KeitoKuramochi/sensor_infrared/site/images/wiring-1.jpg

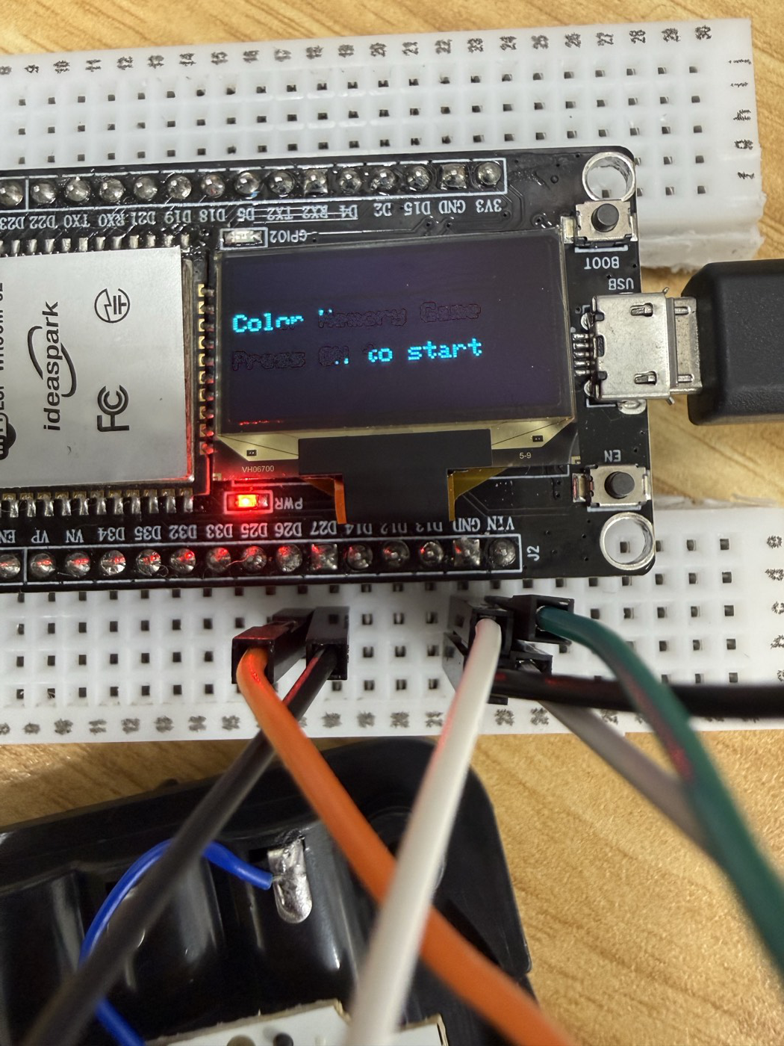
site/images/wiring-1.jpg
