KeitoKuramochi/sensor_infrared/site/images/setup-bt.jpg

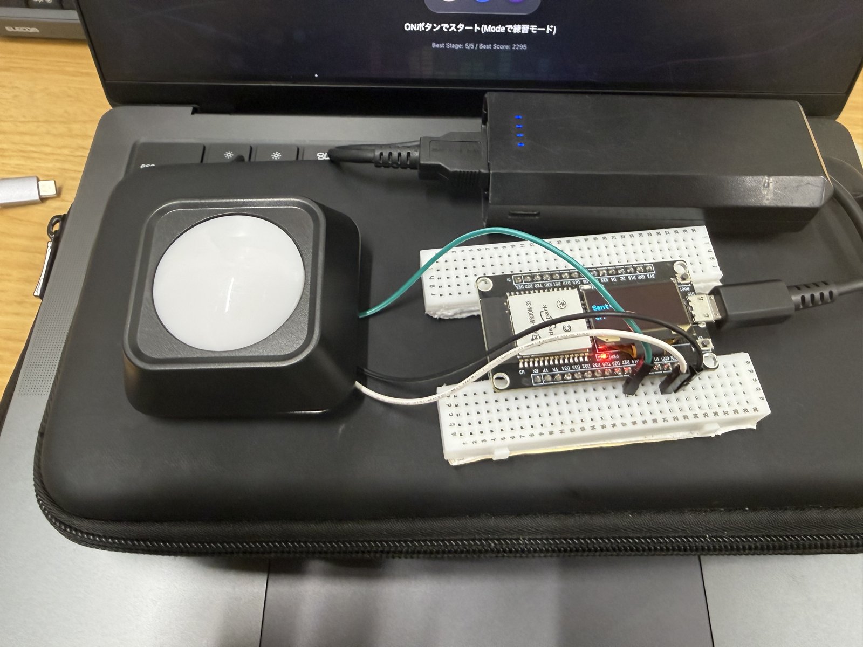
site/images/setup-bt.jpg
