KeitoKuramochi/sensor_infrared/SESSION_LOG.md

# Session Log

このファイルは、どのセッション/どのマシンからでも「今何をしているか」を共有するための進捗ログです。
新しいセッションを始めるときはまずこのファイルを読んで直近の状況を確認し、作業を終える前に新しいエントリを一番上に追記してください(過去のエントリは消さない)。

フォーマット:

```
## YYYY-MM-DD HH:MM - 短いタイトル
- やったこと
- 現在の状態
- 次にやること
```

## 2026-08-03 - 「まず読むメモ」(START_HERE.md)を作成 + ルート直下を 素材/ に整理 + フォルダ改名の調査(改名は未実施)

- ユーザー要望①「このフォルダ名を sensor から opencampus2026 系に変えたい。セッションが引き継げない等はあるか」
  → プランモードで調査したが、名前の確定前にユーザーが方針転換したため **改名は未実施**。調査結果だけ残す:
  - **会話履歴は引き継がれない。** Claude Code は cwd のパスから履歴フォルダ名を作るため
    (`/Users/.../hobby/sensor` → `~/.claude/projects/-Users-kuramochikeito-Desktop-hobby-sensor/`、
    記号は全て `-` に置換)、改名すると空の新フォルダが使われる。現在15セッション・135MB ある。
    履歴フォルダを新しい名前(例 `-Users-kuramochikeito-Desktop-hobby-opencampus2026`)に mv すれば引き継げる
  - `~/.claude.json` の `projects` も絶対パスがキー。改名すると信頼ダイアログが再度出る(実害は軽微)
  - **git は一切影響を受けない**(リモート・履歴そのまま)。`opencampus/` の別リポジトリも無事。
    venv や node_modules は無いので絶対パスの埋め込みも無し
  - **改名するなら必ず直すファイル: `.claude/settings.json`**(フォルダ外書き込み禁止フックが
    旧パスをハードコードしているため、放置すると全ての Edit/Write がブロックされる)。
    他に `CLAUDE.md` 4行目、`動作用.txt` 2行目。SESSION_LOG の過去エントリは履歴なので触らない
  - 日本語やドットを含む名前は履歴フォルダ名が潰れて他プロジェクトと衝突しうるので英数字推奨
  - フォルダ本体の mv と履歴フォルダの移行は**フォルダ外の操作なので CLAUDE.md 上 Claude は実行できない**。
    ユーザーが実行するか、明示的に許可をもらう必要がある
- ユーザー要望②「このフォルダで何をしたか、記事みたいに超見やすくまとめた『まず読むメモ』を作って」
  → **`START_HERE.md` を新規作成**。README(手順書)・SESSION_LOG(作業記録)とは別の、5分で全体を掴む用の1枚:
  - 一行要約 / 現在の構成(mermaid図 + 区間ごとの通信方式の表)/ 動かし方3ステップ / フォルダの歩き方
  - 「これまでの物語」を7章立てで記事化(100均で部品を漁る → 無線との長い戦い → 見た目 → ガチャ連携 →
    展示に耐える形へ → 本番と有線回帰 → 外向けページ)。**2回の誤診(無線ハード故障・アンテナ劣化)も明記**
  - ハマりどころ早見表(bleak<3、広告パケット31B、response=True、UUID衝突、置き場所、色ズレ、ブラウンアウト)
  - CLAUDE.md のルール要約 / もっと知りたいときの参照先
  - **「いま追いついていないこと」を新設**(調査で判明した実態とのズレ):
    ①README のガチャ連携章が WiFi(gacha.local)前提のままで、実際は 8/1 に USBシリアル直結へ移行済み。
    リポジトリ構成の★も `gacha_lock_wifi` を指している ②SESSION_LOG に 8/1 午後の作業
    (USBシリアル化 d98787a / カウントダウン修正 / 全画面表示 9a73231)のエントリが無い(コミットのみ)
    ③デモ動画の音声確認が未完 ④任意のガチャ機全景写真
  - `README.md` の冒頭に START_HERE.md への導線を1行追加
- ユーザー要望③「フォルダがゴチャゴチャ、jpegの名前が訳分からん。改名・移動して、まとめ直して」
  → **ルート直下に散らばっていた写真13枚・4K動画2本・PDF1枚を `素材/` に集約し、全部に意味のある名前を付けた**
  - **どの写真が何なのかは、PILで元画像と `site/images/` などの加工済み画像の相関を取って機械的に同定した**
    (24x24グレースケールの正規化相関)。13枚中12枚が相関1.00で一意に確定。残りは実際に画像を見て判断
  - 新構成: `素材/写真_製作/`(01〜12、製作過程)/ `素材/写真_オープンキャンパス/`(01〜04、8/2撮影)/
    `素材/動画/`(01〜03、4K元データ計750MB)/ `素材/AI生成画像/`(ゲーム画面・ガチャ機ディスプレイに二分)/
    `素材/印刷物/` / `素材/_プロジェクト外/`
  - **`素材/README.md` に「今の名前 ⇄ 元のIMG番号 ⇄ 加工後の掲載先」の対応表を作成。**
    SESSION_LOG の過去エントリは `IMG_6493` 等の元番号で書かれているので、この表で辿れるようにした
  - `画像/` は空になったので削除(中身は `素材/AI生成画像/` と `素材/写真_オープンキャンパス/` `素材/動画/` へ)
  - 判明したこと2件: ①`Generated Image July 27, 2026 - 5_42PM.jpg` は `ライフ.jpg` と完全同一(相関1.00)の重複
    → `ライフ_重複.jpg` にリネーム ②**`IMG_6491 2.jpeg` はこのプロジェクトと無関係な写真**
    (Web3/AI概論のクリアファイル。**氏名入りステッカーが写り込んでいる**)→ `素材/_プロジェクト外/` に隔離し、
    START_HERE と 素材/README に「git に上げるな」と明記。gitignore 対象なので現状コミットの危険はない
  - `.gitignore` を `/画像/` → `/素材/*` + `!/素材/README.md` に変更(中身は無視、対応表だけ追跡)。
    ルート直下への撮影ファイル混入の保険(`/*.jpeg` 等)は残し、`/*.mp4` を追加
  - ゴミ掃除: 空の `pc_game/firmware/gacha_lock_ble/`、`firmware/gacha_lock_ble/__pycache__`、`画像/.DS_Store`
  - 旧パスを参照していた `opencampus/README.md` と `opencampus/videos/README.md` の2箇所も新パスに修正
    (**opencampus は別リポジトリなので未コミット。ユーザーの判断待ち**)
  - `START_HERE.md` を整理後の姿にまとめ直した: フォルダの歩き方にツリー図を追加、`画像/` 行を `素材/` 行に差し替え、
    **紛らわしい点として「ガチャ機の画像生成ツール(make_images.py・src_*.jpg)が旧版の gacha_lock_ble に
    置いたままで、現行 gacha_lock_serial の images.h もそこから生成される」ことを明記**
- 現在の状態: START_HERE.md 作成・整理反映済み、ルート直下はドキュメント4つ+プロジェクト4フォルダ+動作用.txt+素材/ のみ。
  親リポジトリはコミット・プッシュ済み。フォルダ改名は保留(ユーザーの指示待ち)
- 次にやること: ①opencampus 側の2ファイルの修正をコミットするか判断 ②改名するなら上記の3ファイル修正 +
  ユーザーによる mv + 履歴フォルダ移行 + Claude Code 再起動 ③START_HERE.md に挙げた「追いついていないこと」の解消
  (README のガチャ章を USBシリアルに書き換え、8/1 午後の作業を SESSION_LOG に追記)

## 2026-08-01 - オープンキャンパス解説ページを更新(先頭にデモ動画枠 / ガチャ側の通信をWiFiに書き換え)

- 対象は別リポジトリの `opencampus/`(sensor_infrared 側では gitignore、リモート= opencampus-sensor-lab)
- **① 先頭にデモ動画セクションを新設**: ヒーローの直後に「01 まずは、動いているところを見てください」を追加。
  既存セクションの番号を全て +1 して 01〜15 に振り直した(HTMLコメントの番号・ジャンプナビ・README も追随)。
  動画ファイルはまだ無いので、点線プレースホルダ枠 + すぐ差し替えられるコメントアウト済み `<video>` を設置。
  `videos/README.md` に差し込み手順(mp4変換コマンド、来場者の顔が写り込んでいないかの確認)を記載。
  `style.css` に `.video-wrap` / `.video-note` / `figure.video-todo` を追加
- **② PC⇄ガチャ機の通信を BLE → WiFi に記述変更**(実装は既に `firmware/gacha_lock_wifi` に移行済み。
  ページの説明だけが BLE のまま取り残されていた):
  - 全体構成図(セクション07)の矢印ラベルを BLE → WiFi(行き・帰りとも)、ESP32②の説明を「/unlock を受信」に。
    区間ごとに無線が違うことを図中の注記と本文でも明示
  - セクション09を大幅改稿。①リモコン側=BLE(引き出し=キャラクタリスティックの説明は維持し、対象を
    ESP32①→PCの片方向通知に描き直し) ②ガチャ側=WiFi+HTTP を新規に追加(URL表 / PC⇄ルーター⇄ESP32の図 /
    `/status` のJSON返答を terminal 風ブロックで提示 / mDNS で `gacha.local` を名乗る話)。
    ハマった話も「BLEだと切断で"排出した"を取りこぼす → ポーリングできるWiFiへ」に差し替え
  - セクション11の「PCも状態を見張っている」を、通知ベース → 0.4秒ごとのポーリングの記述に修正
  - セクション12(無線の使い分け)の表の役目欄を実態に合わせ、本文を「WiFi→BLE→片方だけWiFiに戻した」経緯に改稿。
    **ユーザーの要望どおり「ルーターを使っている」ことを利点として言い換え**: ESP32は両方内蔵しているので
    区間ごとに向いた方を選べる / WiFiという逃げ道を持てること自体が保険になる、という締めにした
- 検証: HTMLのタグ対応をパーサでチェック(不一致・未閉じなし)。Chrome headless で新規セクションを実レンダリングし、
  SVG図・表・terminal ブロックの崩れが無いことを目視確認。横スクロール(scrollWidth == clientWidth)も確認済み
- **現在の状態: ユーザーの許可を得て opencampus リポジトリに push 済み**(`ff66d5d..73e36e7`)。
  A4ポスターの生成プロンプト(前エントリ)も同時に上がった。Vercel が自動デプロイするので本番に反映される
- **③撮影リストを作成** (`opencampus/SHOOTING_LIST.md`、push 済み): ユーザーが翌日(8/2)に素材を撮影するとのことなので、
  動画1本+写真3枚それぞれについて「必ず写すもの」「アングル」「注意点」をまとめた。
  横向き推奨の根拠はCSS実測(写真 `max-height:340px` / 動画 `max-height:480px`)。
  任意で「ガチャ機全体の写真」も提案(ページに全景が1枚も無いため。撮ってきたらセクション07に枠を作る)
- **④同日中にユーザーが撮影完了、素材を反映して push 済み**(`74218b6`)。プレースホルダは全て解消:
  - 動画 `IMG_6539.MOV`(4K/HEVC・52秒・317MB)→ `videos/demo.mp4`(1280x720 H.264 + AAC・約10MB、faststart付き)。
    内容は 目標選択→プレイ→151点で目標100点達成→「かいじょ!まわしてね」→ハンドルを回す→カプセル排出→「ロック中」に戻る
  - 写真4枚を「EXIF回転を正規化 → トリミング → 長辺1600px → JPEG q84」で書き出し。
    セクション08=サーボと回転盤の歯、セクション09=ESP32の正面(ロック中の画面)と裏側(配線)を `photo-grid` で横並び、
    セクション10=排出口の反射型IRセンサー(記事で触れている感度調整のつまみが写っている)
  - **正面写真の背景に来場者が写り込んでいたのでトリミングで除去した。** 動画の方は35秒以降の背景に
    遠景の来場者が写るが、全画面で見ても足元のみで顔は判別不能なレベル
  - **音声は残してある。私が聴けないため、会話が入っていないかはユーザーの確認待ち**
    (入っていた場合は `-an` で無音化、または該当区間だけ音量を落とす対応が可能)
  - 元データ(4K動画・4032pxの写真)はリポジトリに入れず `画像/opencampus素材/` に退避。
    opencampus 側の `.gitignore` に `images/IMG_*` `*.MOV` 等のガードも追加
- 次にやること: ①ユーザーが動画の音声を確認 ②任意の追加撮影(ガチャ機全体・ブース全景)があれば
  セクション07に枠を作って追加

## 2026-07-31 - オープンキャンパス用A4ポスター(QRドーン)の生成プロンプトを作成

- ユーザー要望: 解説ページ(`opencampus/index.html`)へのQRコードを作ったので、それをA4で印刷してガチャ機の横に
  置いて宣伝できる「ほぼQRコードドーン」のポスターを作りたい。そのための画像生成プロンプトが欲しい
- `opencampus/POSTER_PROMPT.md` を新規作成。ガチャ機ディスプレイ画像(`firmware/gacha_lock_ble/PROMPTS.md`)と
  同じ世界観(フラットベクター/ネオン発光/濃いチャコール #111318/リモコン型マスコット)で統一。
  配色は `opencampus/style.css` の変数(accent #6fb3e8 等)から採用
- **設計上の要点: QRコード自体はAIに描かせない方針にした。** 画像生成AIの描くQRは読み取れないため、
  「中央に真っ白な正方形(プレースホルダ)が空いたポスター」を生成させ、そこに本物のQR画像を後から重ねる手順にした。
  プロンプト内でも "Do NOT draw a QR code / any dots, patterns, grids" と明示的に禁止している
- 併せて記載: ①日本語が崩れたとき用のフォールバック(文字を一切描かせずCanva等で入れる) ②明るい配色版
  ③QR画像を直接AIに渡す方式の注意 ④確実性優先ならHTML+CSS→ブラウザPDF出力
- 現在の状態: プロンプトのみ提供。ポスター画像の生成・印刷・読み取りテストはユーザー側でこれから
- 次にやること: ユーザーが生成して文字崩れ等の問題が出たら、HTML+CSSでの印刷用ポスター版を作る(未着手)

## 2026-07-31 - ガチャ機ディスプレイの画像化完了 + ゲーム性の改良(練習エンドレス/目標点数選択/結果画面/管理者パネル)

- **ガチャ機ディスプレイの画像化**: ユーザーがAI生成した3枚(ロック中/かいじょ!/ありがとう!)を採用。1424x752(比率1.89:1)で
  目標の320x170(1.88:1)とほぼ一致したためトリミングほぼ無し。日本語も崩れず綺麗。`make_images.py` でRGB565に変換して
  ファームに埋め込み、実機で3画面の遷移(解錠→排出検知→お礼3秒→ロック)を確認。後に「ロック中」の文言を
  「500てんとってね」→「高得点を目指そう!」に差し替え済み
- **練習モードをエンドレス化**: 「押したら光るだけ」から3拍ごとにノーツが流れ続けるモードへ。絶対ビート番号で管理し、
  必要分だけ遅延生成して古いノーツは破棄(サーバー・クライアント双方)。ライフは減らずゲームオーバーにもならない。
  **ユーザー指摘で判明した実装漏れを修正**: 色ノーツの間の「空ビートの輪」を流していなかったため拍が取れず、
  メトロノーム音も鳴っていなかった。サーバーが描画すべきビート範囲(window)を返す方式にして解決
- **目標点数を挑戦者が選べるように**: 固定500点をやめ、プレイ前に `target_select` フェーズを挟んでリモコンの色ボタン5つに
  プリセットを割当(赤100/緑250/青500/橙1000/黄緑2000)。選んだ目標に到達したときだけ解錠する。
  各ステージの累計点の目安(69/243/594/1230/2295)も画面に表示。全クリア時のスコアが理論値2295と完全一致し、目安の正しさも裏付け
  - **ユーザー指摘で2点改善**: ①縦積みだとリモコンが画面外に切れる → サイドパネル等を隠して目標リストとリモコンを横並びに
    (1100x680〜1440x900でリモコン全体が収まることを実測) ②画面の色の丸だけでは実機のどのボタンか分からない →
    1秒ごとに かんたん→…→神 の順でリストの行と実機リモコンの該当ボタンを同時にハイライトして対応を示す
- **結果画面を新設**: 結果が1行メッセージだけで「失敗して終わり」に見えていたため専用パネルに。スコアと目標を並べて
  達成なら「≥」、未達なら「<」+「あと○点でした」を明示。達成時はガチャの進行を4段階
  (ロック解除→ガチャを回す→カプセル排出→再ロック)で段階表示
- **ガチャのロック状態を追跡して次の人へ繋ぐループ**: ファームが送る "LOCKED"/"UNLOCKED"/"DISPENSED" 通知を
  `state.gacha.device` に反映し、BLE接続状態も `connected` で保持。解錠が通ったら `awaiting=True` にして、
  ガチャ機から "LOCKED" が返るまで(=カプセルが出て再施錠されるまで)次のゲームを始められないようにした
  (解錠したまま次の人が引ける事故の防止)。解錠コマンド送信中(pending)も同様に弾き、UI側もONボタンを光らせない。
  再施錠を確認したら「ありがとうございました! 次の人どうぞ」に切り替わる。詰まったら OFF で手動リセット可
- **管理者パネルを追加**(右下常駐・合言葉なし): イベント中のもしもの時に運営が手動介入できる逃げ道。
  - ファームに **LOCK(強制施錠)と STATUS(状態問い合わせ)を新規追加**(UNLOCKしか無かったため)
  - サーバー: BLE書き込みを `send_gacha_command()` に切り出し、`POST /admin/action` を追加
    (gacha_unlock / gacha_lock / gacha_status / game_reset / clear_awaiting / ranking_clear)
  - 画面: 🛠ボタン(既定は半透明)を開くとガチャ機BLE接続・ロック状態・ゲーム状態・待たせ有無をライブ表示し、
    各操作ボタンと結果メッセージを表示。破壊的な「今日の記録を消す」は confirm を挟む
  - **実機で全経路を検証済み**: 管理パネルのボタン → BLE → ESP32 で「STATUS→施錠 / UNLOCK→解錠 / LOCK→施錠」が
    ライブ反映されることを確認。特に**解錠中にLOCKで即施錠できる**ことを確認(もしもの時の本命機能)
- 【重要な訂正】**「ガチャ機ESP32のアンテナ/RFが劣化している(同機種比較で20dB弱い)」という以前の結論は誤りだった。**
  ユーザーの「初期化して調査したい」を受けて再調査し、以下が判明:
  1. **2台は別チップだった** — ガチャ機=ESP32-D0WD **rev v1.1**(MAC a0:a3:b3)、リモコン側=ESP32-D0WD-**V3** rev v3.1
     (MAC b0:b2:1c)。さらにガチャ機は1.9インチLCD付きボード、リモコン側はOLED付きボードで**機種も別**。
     つまり「同機種・同条件の比較」が最初から成立しておらず、20dB差の解釈が誤っていた
  2. **置き場所を変えたら -66dBm まで改善し、リモコン側(-76dBm)より強くなった**(2回測定して再現)。
     以前の -84/-90dBm や「全く検出できない」状態は、単に置き場所が悪かっただけ
  3. 接続品質も実測で良好: 接続まで2.1秒、93秒連続で STATUS 送信9回成功・0回失敗・切断なし
     (93秒時点の切断はテストスクリプトの正常終了によるもの)
  → **ボードは正常。原因は純粋に設置位置だった。** 交換は不要
- 再発防止として、管理パネルに **BLEの接続品質(接続してからの経過時間・再接続回数)** を表示するようにした。
  再接続0回なら緑、増えるほど警告色。置き場所が悪いと運営がすぐ気づける
- ranking_clear のテストで今日の記録4件を削除した。中身は全て私のテスト実行(2295点の自動満点プレイ、0点の無操作テスト等)で
  実プレイ記録ではないことを事前に確認済み。7/30の14件は無傷
- 🎉 **最後にユーザーが実機のリモコンで通しプレイを確認済み**(目標選択→プレイ→達成→解錠→カプセル排出→再施錠→次の人)。
  これで全経路が実機で動作確認できた:
  IRリモコン → ESP32受信 → BLE → Mac(判定・目標比較) → BLE → ガチャ機ESP32 → サーボ解錠 →
  赤外線センサーでカプセル検知 → 再施錠 → PCへ通知 → 「次の人どうぞ」
- 残タスクは特になし。今後の改善候補: 練習モードの3拍間隔やハイライト巡回速度などの体感調整、
  イベント設置時は管理パネルで再接続回数が増えないことを確認すること

## 2026-07-30 (続き) - 🎉 ガチャ連携が実機で完全動作!「無線ハード故障」判断は誤りだった + ディスプレイ画像化に着手

- **前エントリの「ESP32の無線ハードウェア故障」という結論は誤りだった。** ユーザーの「諦めるな、最初から洗い直せ」という
  指示を受けて再調査し、実際は**私のコードに2つのバグがあった**ことが判明。以下の順で切り分けた:
  1. フラッシュ全消去(`esptool erase-flash`、NVS/RF校正データもクリア)→ 変化なし
  2. 友人のオリジナル `gacha_ap.ino` をそのまま焼く(ユーザーの提案)→ こちらも電波が出ず、私のコード起因ではないと確認
  3. **ESP32自身にWiFiスキャンさせる**テスト → **16ネットワークを -64dBm で受信**。つまりアンテナ・RF回路は生きていた。
     ここで「ハード故障」説が崩れた
  4. 名前を広告本体に入れた最小BLE広告テスト → **-93dBm で検出成功**。電波は出ていた(ただし極端に弱い)
- **バグ①(発見の失敗)**: 広告パケットで「デバイス名をスキャン応答、サービスUUIDを広告本体」に入れていた。
  スキャン応答は往復通信が必要なため、電波が弱いとデバイスとして**全く発見できない**。名前を広告本体に直接入れ、
  UUIDをスキャン応答に回す構成へ変更(+ `NimBLEDevice::setPower(9)` で送信出力を明示的に最大化)
- **バグ②(解錠されない真因)**: ファーム側はキャラクタリスティックを `WRITE`(応答あり)で定義しているのに、
  PC側が `response=False`(Write Without Response)で送っていたため、**書き込みが破棄されていた**。
  これが「接続は成功するのに解錠しない」の正体。`response=True` に修正(到達確認も取れる)
- 修正後、実機で **BLE接続 → UNLOCK送信 → ESP32から "UNLOCKED" 通知** までE2E成功。
  その後ユーザーが**実際にゲームをプレイして500点以上を達成 → ガチャが解錠 → 赤外線センサーがカプセルを検知 → 自動で再施錠**
  までを外部電源(完全ワイヤレス)で確認。**当初の目標を完全達成**
- 電波強度の実測(同機種2台を同距離で比較): ColorMemoryGame **-70dBm**(93回検出/25秒) vs GachaLock **-83〜-90dBm**(8〜53回)。
  ガチャ機側は正常なボードより **8〜20dB 弱い**(原因は特定できず。近づけても-90から改善しない挙動も観測)。
  動作はするが位置によって不安定になりうるので、設置時はPCに近づけること
- 次の要望に着手: ガチャ機ディスプレイの表示が図形(赤い⊘/緑の○)でチープなので、AI生成画像に置き換えたい。
  横長320×170のフルカラー液晶なので画像表示は可能。以下を実装済み:
  - `firmware/gacha_lock_ble/PROMPTS.md`: 3枚(ロック中/解錠中/ありがとう)のAI生成プロンプト。既存マスコット
    (リモコン型キャラ)とアートスタイル(フラットベクター/ネオン/濃いチャコール)を踏襲。ユーザーの希望で日本語文字入り
  - `firmware/gacha_lock_ble/make_images.py`: 画像をRGB565のC配列(`images.h`)に変換。中央基準でcover trim+縮小
  - ファーム側: `images.h` があれば全画面イラスト表示、無ければ従来の図形描画にフォールバック(`__has_include`で切り替え)。
    **新規に `ST_THANKS` 状態を追加** — カプセル検知時に先にサーボを施錠してから「ありがとう」を3秒表示し、その後ロック画面へ
  - 仮画像でパイプラインを検証済み。コンパイルは画像なし50% / 画像3枚で75%(1.31MB中)。4枚以上なら `PartitionScheme=huge_app` を案内
  - `images.h`(自動生成・約1.1MB)は `.gitignore` に追加
- 次にやること: ①ユーザーがPROMPTS.mdのプロンプトで3枚生成 → `firmware/gacha_lock_ble/` に `src_locked`/`src_unlocked`/`src_thanks`
  として保存 → `make_images.py` 実行 → 書き込み → 実機で表示確認 ②日本語文字が崩れたら、絵だけ生成してもらいPIL+ヒラギノで
  文字を焼き込む方式に切り替える ③ガチャ機ESP32の電波の弱さは未解決(実用上は動作するが、安定性を上げたいならボード交換)

## 2026-07-30 - ガチャガチャロック連携(友人プロジェクト)を実装、実機はBluetoothハード故障と判明(※上のエントリで訂正)

- ユーザー要望: 友人([MaedaReno/gacha-machine](https://github.com/MaedaReno/gacha-machine)、ESP32+サーボ+赤外線センサーでガチャガチャの
  ロックを解錠する装置)と、この色記憶リズムゲームを連携させたい。ゲームで500点以上取ったらガチャのロックが解除される仕組み
- 先方リポジトリを調査: `servo_mod/firmware/gacha_ap.ino` がまさに「ミニゲームクリア時に叩く」想定のWiFi AP+HTTP解錠(`/unlock?key=open`)
  エンドポイントを持っていた。当初はこれをそのまま叩く実装で着手(`GACHA_HOST`等の環境変数、`urllib`でのHTTP呼び出し)
- ユーザーから「Bluetoothで完結させたい」(WiFiの繋ぎ変え不要にしたい)との要望を受けて方針転換。先方リポジトリにBluetooth版は
  無かったため、**新規にBLEファームウェアを自作**することに: `firmware/gacha_lock_ble/gacha_lock_ble.ino`
  (先方の `gacha_main.ino` の状態遷移(サーボ施錠/解錠+赤外線センサーでのカプセル落下検知)をベースに、トリガー部分だけを
  `color_memory_game_ble` と同じNimBLE(Nordic UART Service互換UUID)方式に置き換え、ボタン/シリアルは手動フォールバックとして残置)
- `pc_game/game_server.py` にBLE版のガチャ連携を実装: `gacha_ble_reader()`(色記憶ゲームの`ble_reader()`と同じ設計、
  「GachaLock」を自動検出して常時接続維持)、`maybe_unlock_gacha()`(ゲーム終了(Game Over/ALL CLEAR問わず)時に
  スコア≥`GACHA_UNLOCK_SCORE`(既定500、環境変数で変更可)ならBLEで解錠コマンド送信)。フロントエンド(`templates/index.html`)にも
  解錠中/成功/失敗のメッセージ表示を追加。ダミーのgame-over注入テストで、閾値未満は反応せず・閾値以上は送信試行→未接続時は
  タイムアウトして`error`状態になる、をコード上で確認済み(いずれもゲーム進行をブロックしない設計)
- ユーザーの実機(ガチャ機用ESP32、ideaspark製 ESP32-WROOM-32 1.9インチST7789ボード、サーボ=GPIO26・赤外線センサー=GPIO25)を
  USB接続してもらい、`firmware/gacha_lock_ble`をarduino-cli(115200bps)で実機書き込み・コンパイル確認済み。しかし実機テストで
  **「BLE advertising as: GachaLock (start=OK)」とシリアルには出るのに、Mac側のBLEスキャン(bleak)には一切現れない**現象が発生
- 切り分けのため、①NimBLEのみの最小広告スケッチ(`/tmp/ble_probe`、他のライブラリ一切なし)でも同様に不可視 ②金属面設置の
  可能性をユーザーに確認→非金属設置で問題なしと回答 ③**WiFi APモードの最小テストスケッチ(`/tmp/wifi_probe`)でも
  ユーザーのMacのWiFiメニューに一切表示されない**ことを確認、という3段階の切り分けで、**BLEだけでなくWiFiも電波が
  出ていない=この個体のESP32の無線ハードウェア(アンテナ/RF)自体が故障している**と結論(ソフトウェア側の実装は
  正常であることを確認済み。同型のideasparkボードは色記憶ゲーム側でBLE動作実績あり)
- 診断用に追加した一時的なデバッグ出力(ハートビート/MACアドレス表示)は削除し、`firmware/gacha_lock_ble/gacha_lock_ble.ino`の
  最終版を実機に書き戻し済み(現状は無線が出ないため動作確認はできないが、正常なESP32に差し替えれば書き込むだけで動くはず)
- README.mdに「ガチャロック連携(任意)」セクションを追加(配線・BLE UUID体系・環境変数・この無線故障の注意点)
- **【重要・ユーザーへの謝罪事項】** このセッション中、`pc_game/ranking.json`(実際のプレイ履歴が入ったランキングデータ、
  gitignore対象で非コミット)を、テスト用一時ファイルの片付けのつもりで `rm -rf __pycache__ ranking.json` を実行し**誤って削除した**。
  gitでも管理されておらずTime Machine等のバックアップもこの環境からは確認できず、復旧不可能。ユーザーには即座に報告・謝罪済み。
  実害はコードには無く、次回プレイからランキングが空の状態で積み上がり直す
- コミット・プッシュ後、ユーザーの依頼で実際に`game_server.py`を起動して動作確認したところ、**重大なバグを発見**:
  ログに`[GACHA-BLE] status: ON`/`status: OFF`が、ColorMemoryGame側のボタン操作と完全同期して出ていた。
  原因はGachaLockとColorMemoryGameの両ファームで**同じNordic UART Service UUID(6E400001...)を使っていたため**、
  `gacha_ble_reader()`のサービスUUID一致判定がColorMemoryGame側ESP32に誤ってマッチし、そちらに接続してボタン通知を
  ガチャの状態として受信していた(実害は無し。スコアが閾値未満だったため解錠コマンド送信=誤書き込みは発生していない)。
  GachaLock側のService/RX/TX UUIDを専用の値(`3F316DB0/1/2-...`)に変更して分離・再検証済み(ColorMemoryGameは正常接続、
  GachaLockは「探しています...」を繰り返すだけになったことを確認)。修正をコミット・プッシュ済み
- 現在の状態: PC側実装・BLEファームウェアは完成、UUID分離バグも修正済みでコンパイル・部分的な実機動作(ColorMemoryGame接続/
  GachaLock誤接続の解消)を確認済み。ガチャ機ESP32個体の無線ハードウェア故障(BLE/WiFi共に電波が出ない)によりガチャ側との
  E2E動作確認(実際の解錠)はまだ未完了。ユーザーは代替ESP32が「あるか」を明言しておらず(Amazon商品ページの情報提供のみ)、
  その場での交換テストは未実施
- 次にやること: ①ユーザーが正常な(無線が生きている)ESP32を用意 → `firmware/gacha_lock_ble`を書き込み → `game_server.py`起動時に
  「GachaLock」に自動接続することを確認 → 実際にゲームをプレイして500点以上でガチャが解錠されるかのE2Eテスト ②現在のガチャ機
  ESP32が本当に修理不能かどうかの判断(はんだ再検査/RFテスターがあれば)。関連コミットは2件ともコミット・プッシュ済み
  (549b4df: 初期実装、e1666ca: UUID分離バグ修正)

## 2026-07-28 18:57 - オープンキャンパス向け技術解説ページを新規プロジェクト(別リポジトリ)として作成

- ユーザー要望: オープンキャンパス来場者向けに、この工作(100均センサー分解→ESP32→リズムゲーム)の技術的な要素(赤外線センサー・マイコン・配線・無線通信)を解説するページを新規作成したい。既存の制作記録(site/、個人ブログ的なトーン)とは別物で、来場者が「情報工学科に興味を持つきっかけ」になるような技術解説寄りのページにしたいとの依頼。来場者アンケートも付けたい
- 途中でユーザーから追加指示: 「新しいプロジェクト作って新しいリポジトリ作ってVercelで公開できるようにしといて。アンケートはちゃんとデータとして残したい」→ 本体プロジェクト(sensor_infrared)とは**別の独立リポジトリ**として構築する方針に変更
- CLAUDE.mdの「プロジェクトフォルダ外を編集しない」制約があるため、新規リポジトリは `/Users/kuramochikeito/Desktop/hobby/sensor/opencampus/` (このフォルダの中のサブフォルダ)に作成し、そこだけ独立したgitリポジトリとして`git init`。親リポジトリの `.gitignore` に `/opencampus/` を追加してネスト管理を回避
- ページ構成(`opencampus/index.html` + `style.css`、素のHTML/CSS・ビルド不要・新規デザイントークン): ①100均で見つけた300円センサー ②分解写真(**CSS+SVGオーバーレイで「赤外線受信部」「RGB LED」の位置に注釈ラベルを重ねた**、写真のピクセル座標をPython/PILでグリッド画像を作って目視確認して算出) ③VS838→ESP32配線図(OUT→GPIO27/GND/3V3、既存記事と同じ確定済みデータを再利用)+「センサーはVCC/GND/信号の3本パターンが多い」という一般化 ④Arduino IDEのシリアルモニタを再現したターミナル風UI(実際に確定済みのIRコード表のデータを使用、フェイクではなく実データの再現である旨を明記) ⑤ESP32とは何か(キットのArduino UNO R3との比較) ⑥赤外線/WiFi/Bluetoothの使い分け比較表 ⑦**`写真/白背景スタジオ風/`のELEGOO UNO R3スターターキット写真からセンサー18点を厳選**(PIR人感・DHT11温湿度・CdS光・雨滴水位・超音波距離・ジャイロ加速度・ロータリーエンコーダー・ジョイスティック・赤外線受信モジュール・RFID・音・RTC・LCD1602・サーボ・LEDドットマトリクス・7セグメント等)し、sipsで900px/JPEG82%にリサイズして紹介ギャラリーを作成 ⑧学科CTA(具体的な学科名・URLは今回入れない方針、ユーザー確認済み) ⑨来場者アンケート(Googleフォーム埋め込み方式をユーザーが選択。ページには質問文プレビューとCTAボタンを設置、フォームURLは `https://forms.gle/REPLACE_WITH_YOUR_FORM_LINK` のプレースホルダのまま=index.html 401行目、ユーザーがGoogleフォームを作成後に差し替えが必要)
- Playwrightでライト/ダーク・PC(900px)/スマホ(390px)を検証し、実装中に2つのバグを発見・修正済み: ①`.terminal-bar span`のCSSセレクタが意図せずラベルspanにも適用され9px角に押し込まれて文字が縦に1文字ずつ折り返る表示崩れ→ドット用に`.terminal-dot`クラスを分離して解消 ②基板注釈ラベルの文字色が`var(--ink)`(テーマ依存)だったため、ダークモードで白背景ラベルに白文字が乗って読めなくなっていた→ラベルは常に固定の濃い色に変更して解消
- 新規GitHubリポジトリ **https://github.com/KeitoKuramochi/opencampus-sensor-lab** を`gh repo create --public`で作成し、初回コミット・プッシュ済み。機密情報チェック済み(secrets/env等の混入なし)
- Vercel CLIはこの環境ではログイン済みトークンがなく(`vercel whoami`が失敗)、非対話的にはデプロイできない状態。**ユーザーが `! npx vercel login` を実行してログインする必要あり**(その後 `npx vercel --prod` でデプロイ、またはvercel.comダッシュボードから新リポジトリをImportする方法でも可)
- ユーザーから「新しい画像送るから欲しいものあったら言って」と申し出があり、①Arduino IDEのシリアルモニタの実際のスクリーンショット/画面録画(現在は実データ再現のテキストUIで代用) ②VS838の3本の線がESP32につながっているクローズアップ写真 ③スターターキットの収納ケース全体の写真、をリクエスト済み(未着)
- 次にやること: ①ユーザーがVercelにログイン→デプロイ→公開URL確定 ②公開URL確定後、QRコード画像を生成(python `qrcode`パッケージが利用可能と確認済み) ③ユーザーがGoogleフォームを作成(質問文はページ内`survey-preview`と同内容をチャットで提示済み)→ `index.html` 401行目のプレースホルダURLを実際のフォームリンクに差し替え ④追加送付される写真(上記3点)を差し替え

## 2026-07-27 - Claude Codeのステータスラインに「Fable専用の使用率バー」を追加できるか調査(コード作業なし、本プロジェクトと無関係)
- ユーザー要望: ターミナル下部の5時間制限/週次制限バーと同じように、Fableモデルの使用量も常時バーで表示したい
- `~/.claude/statusline.sh`(本プロジェクト外、ユーザーのグローバル設定)を確認。既に前回セッションで同じ検討をした跡があり、コメントで「Fableの利用は5h/週次バーの枠を共有しており専用の残量表示は存在しない」と結論済みだった
- 今回、実際に動いているCLIバイナリ(v2.1.220)の文字列を直接確認して技術的に再確認: ステータスライン用JSONの`rate_limits`は`five_hour`/`seven_day`の2つのみで、モデル別の内訳は存在しない。Fable使用分はこの2つの数字にすでに含まれている
- Fableは基本枠超過時に別会計の「usage credits(前払いクレジット)」を消費する仕組みがあるが、その残量/消費量はCLIのどのサブコマンド・ステータスラインJSONにも公開されておらず、社内API(`/api/oauth/organizations/:orgUUID/prepaid/credits`、組織管理者向け・別認証)しか存在しないため、スクリプトから安定して取得する手段がないと判明
- 結論としてユーザーに「技術的に実装不可能」と回答(現状のFable使用時に金色でモデル名を強調する表示が現実的な最善策)。`~/.claude/statusline.sh`はプロジェクト外のためこのセッションからは編集もできない(フックでブロックされる)ことも案内
- 本プロジェクト(センサー工作)のコード・配線作業は今回なし
- 次にやること: 前回の続き — 通しプレイは既に成功済みなので特に持ち越しタスクなし。気が向いたことがあれば都度対応

## 2026-07-27 - 後日談動画の縦横比バグ修正+記事にフローティング目次(ジャンプナビ)を追加
- ユーザー報告: 追記した後日談セクションの動画(demo-bt.mp4)が「潰れてる」。ffprobeで原因確定: 元動画 `IMG_6501.mov` は実データが3840x2160だが `rotation: -90` のメタデータ付き(実際は縦動画)。前回のffmpegコマンドが `scale=1280:720` で横長に強制していたため、縦の内容が横長に押しつぶされていた
- 修正: `scale=720:1280`(既存の demo.mp4 と同じ縦解像度)で再エンコードし直し、ポスター画像も再生成。ffprobeで出力が720x1280になっていること、静止画が正しい縦向きであることを確認済み
- 追加要望「スクロールが大変、ボタンで各セクションに飛べるように」に対応: `site/index.html` にフローティングの目次(`#jumpnav`、右下固定の丸ボタン)を実装。`<details>/<summary>` のCSSのみの開閉(JS不要で動作)+ ビートストリップ風の4色ドットアイコン。開くと全10セクション(デモ/伝えたいこと/きっかけ/100均/なぜこれを選んだか/分解/機材/作り方(技術)/まとめ/後日談)への色チップ付きリンクが並ぶ。リンククリック後にメニューを自動で閉じる最小限のJSも追加。`scroll-behavior: smooth`(reduced-motion配慮)も追加
- Playwrightでライト/ダーク両テーマの開閉・ジャンプ動作を確認済み(ジャンプ後に自動で閉じることも確認)
- 次にやること: プッシュ後にVercelでの表示確認
- ユーザー要望: 公開済み記事(site/)の既存内容は一切変更・削除せず、追記の形で①「実はBluetoothだけでつながった(WiFiルーター不要だった)。AIと話していて知った」②「見た目を変えたらだいぶゲームっぽくなった」を伝えたい
- `site/index.html` のまとめセクションの後ろに新セクション「後日談:実は『Bluetoothだけ』でつながった(2026-07-27 追記)」を追加(#postscript、--c-sky)。既存部分は無変更。内容: WiFi構成→BLEへの転換をAIとの対話の文脈で説明、SPPでハマってBLEで解決した苦労話、画像生成AI+デザイン磨きの報告
- 素材3点を処理して掲載: ①IMG_6501.mov(4K 44秒 275MB)→ 720p H.264 6.5MB `site/videos/demo-bt.mp4` +ポスター画像 ②IMG_6502.jpeg → EXIF回転を除去して横向き1600pxに `site/images/setup-bt.jpg`(最小構成: ライト+ESP32+モバイルバッテリー) ③新ゲーム画面のスクショ → 1600px JPG `site/images/game-screen-v2.jpg`
- Playwrightでセクションのレンダリング確認済み(見出し・写真・キャプション・動画プレイヤーすべて既存デザインと一貫)。プッシュでVercelに自動デプロイ
- 次にやること: デプロイ後に https://sensor-infrared.vercel.app/ で表示確認

## 2026-07-27 - デザイン総仕上げ: ガラス調UIデザインシステムで全面磨き込み
- ユーザー要望「洗練されたこだわった見た目に」に対応し、`templates/index.html` を全面書き換え。CSS変数によるデザイントークン(ガラスパネル/シアン・ゴールドのアクセント/統一角丸)で統一
- 主な変更: ①HUDを「STAGE / SCORE / LIFE」のガラスチップ3枚に再設計(すりガラスblur+等幅数字) ②遊び方パネルをアイコン付きステップに刷新 — 実物そっくりのON/OFF/Modeミニボタン、ノーツ▶輪の図解、EXCELLENT/OK/MISSの判定バッジ ③リズムレーンを改良(判定ゾーンにシアンの発光+左側をほんのり照らす、ノーツに光沢と色別グロー) ④リモコンに質感(グラデ+内側ハイライト+ホバー) ⑤ステージ導入を「READY+グラデ文字+アクセントバー」の演出に ⑥コンボ表示を新設(2コンボ以上で判定の下に「N COMBO」) ⑦ランキング1位の行をゴールドでハイライト ⑧音有効化オーバーレイをカード化、絵文字ファビコン追加
- Playwrightでタイトル/ステージ導入/プレイ中の3画面を確認、MISS行の折り返し崩れも修正済み。ゲームロジック(JS)は無変更(コンボ表示とノーツのグロー追加のみ)
- サーバー再起動済み。ブラウザ再読み込みで反映される状態
- 次にやること: 実機プレイで演出(コンボ・バースト)の見た目確認

## 2026-07-27 - ユーザー生成の画像8枚をゲームに組み込み(トリミング・透過処理込み)
- ユーザーがNano Bananaで生成した画像9枚(1枚は重複)を `画像/` に配置。全部加工してゲームに反映した:
  - 背景→`bg.jpg`(そのまま) / タイトル→`logo.png` / ゲームオーバー→`gameover.png` / 全クリア→`allclear.png` / ステージクリア→`stageclear.png`: PILで余白の自動トリミング+黒背景の透過処理(ページ背景と色が微妙に違い四角く見えるため)
  - マスコット→`mascot.png`: 透過処理して遊び方パネルの上に表示 / ハート→`heart.png`: 透過処理してHUDの❤️絵文字を置き換え(失ったライフはCSSフィルタで暗転)
  - EXCELLENT→`excellent.jpg`: **新実装のバースト演出**。EXCELLENT判定の瞬間に `mix-blend-mode: screen`(黒が消えて光だけ乗る)+拡大フェードで画面にフラッシュ
- サーバー側も拡張: 画像スロットを4→8種(stageclear/excellent/mascot/heart追加)、拡張子はpng/jpg/jpeg/webpどれでも自動検出。ステージクリア画面にもスタンプが出るように
- Playwrightで表示確認済み(ロゴの透過・ハート・マスコット・スタンプ・背景すべてOK)。サーバーは反映済みで起動中
- 元画像 `画像/` はgitignore、加工済みの8ファイルはリポジトリにコミット
- 次にやること: 実際にプレイしてEXCELLENTバーストの見た目確認。ESP32の電源安定化(前エントリ参照)

## 2026-07-27 - 派手化3点セット: 生成AI画像スロット+その日のランキング+テンポ調整
- ユーザー要望に対応: ①ゲームを派手にするためのNano Banana(Gemini)用画像生成プロンプト集 ②画面右にその日のランキングTOP10・左に遊び方 ③テンポを少し遅く
- 画像: `pc_game/static/img/PROMPTS.md` に10種類のプロンプトを用意。うち4つ(bg.png=背景 / logo.png=タイトルロゴ / gameover.png / allclear.png)は**このフォルダに置いてブラウザ再読み込みするだけで自動反映**される仕組みをサーバー(存在チェック)+テンプレート(条件差し込み)に実装。背景は暗いオーバーレイ付きで読みやすさを維持
- ランキング: ゲーム終了(ゲームオーバー/全クリア)時に自動でスコア・到達ステージ・時刻を記録し、`pc_game/ranking.json` に日付キーで永続化(.gitignore対象)。/stateに今日のTOP10を同梱し、画面右パネルに🥇🥈🥉+NEWバッジ付きで表示。左パネルには遊び方を常設。画面幅1220px未満ではパネル非表示
- テンポ: BEAT_INTERVAL_SEC 0.55→0.7(約27%ゆっくり)。カウントインや幕のタイミングは自動追従
- E2E検証済み: 実際に1ゲーム流してランキング記録→表示(NEWバッジ)をスクリーンショットで確認。テストデータは削除してサーバー再起動済み
- 現在の状態: サーバーは新機能込みでバックグラウンド起動中。ESP32はUSBから外されており(電池駆動に移行中?)BLEスキャン待機中 — 電源が入れば自動接続する。電池の再起動問題は上のエントリ参照
- 次にやること: ESP32の電源安定化(モバイルバッテリー推奨)→ プレイしてランキング確認 → 気が向いたらPROMPTS.mdで画像生成して配置

## 2026-07-27 - 電池駆動時の頻繁な再起動の相談(コード作業なし)
- ユーザー報告: 単四電池3本(→VIN/GND)で動かすとESP32が頻繁に再起動する。受信機はD27/GND/VINに接続とのこと
- 見立て: ブラウンアウトがほぼ確実。単四3本=4.5VはVINのレギュレータ(要 約4.4V以上)に余裕ゼロで、BLE送信の電流スパイク(200〜500mA)で電圧サグ→3.3Vラインが2.8Vを割ってリセット、のループ
- 案内した対処: ①モバイルバッテリーのUSB給電(最有力) ②単三4本(6V)をVINへ(充電池3本=3.6VはVIN不可) ③VIN-GND間に470〜1000µFの電解コンデンサ追加 ④接触不良の確認。確認方法としてシリアルモニタの「Brownout detector was triggered」を案内
- 配線の注意も指摘: 受信機(VS838)のVCCがVINに挿さっている場合は3V3へ移すこと(OUTのHIGHが4.5V近くになりGPIOの上限3.6Vを超えるため)。7/21確認済みの正しい配線は OUT→GPIO27 / GND / VCC→3V3
- 【追記】ユーザーの手持ち部品ケースの写真を確認 → **ELEGOO UNO R3スターターキット**と判明。再起動対策に使える部品が同梱: ①Power Supply Module(ブレッドボード電源モジュール) ②100µF電解コンデンサ×2 ③9V電池+スナップクリップ ④9V/1Aアダプタ
- 案内した推奨構成: 9V電池orアダプタ → 電源モジュール(ジャンパを**5V**に設定)→ ブレッドボードのレール → ESP32のVIN/GND、+ESP32近くのVIN-GND間に100µF×2を並列。注意点: コンデンサの極性(長足=+/白帯=−)、VS838のVCCは3V3のまま
- 【決定】ユーザーは**モバイルバッテリーからのUSB給電**を選択。電源モジュール+9V電池案は不採用。補足として案内: ①低電流で自動オフするモバイルバッテリーがある(切れる場合は低電流モード付きを) ②VS838のVCC→3V3への移設は給電方法に関係なく実施推奨
- 次にやること: モバイルバッテリー給電で再起動が収まるか実機確認

## 2026-07-27 - ステージ幕の裏で拍が進んでしまう問題を修正(幕はカウントイン前に上げる)
- ユーザー報告: 「Stage N」の黒幕の裏で1拍目から始まっており、幕が上がる頃には5拍目くらいになっている
- 原因: カウントイン(4拍)を黒幕の裏で消化する作りだったため、幕が上がった瞬間=1拍目到着で、ノーツの接近が全く見えなかった(幕を完全不透明にした修正でこの設計問題が顕在化)
- 対応: サーバーの `INTRO_DELAY_SEC` を「幕表示1.5秒+カウントイン2.2秒」に延長し、クライアントは幕を**カウントイン開始時点で上げる**ように変更。幕が上がってから4拍の間、ノーツが右から近づいてくるのが見えてから1拍目が判定ゾーンに到着する流れになった
- Playwrightのスクリーンショット(+0.8s幕表示 / +2.3sカウントイン中にノーツ接近 / +3.8s 1拍目到着)で動作確認済み
- バックグラウンドのサーバーは修正版で再起動済み(BLEも自動再接続確認)。ユーザーはブラウザの再読み込みだけでOK
- 次にやること: リロードして再プレイ確認

## 2026-07-27 - 🎉 通しプレイ成功!リモコン→ESP32→BLE→PC→ブラウザの全経路が動作
- ユーザーが実機で動作確認: リモコンのボタンでゲームが正常にプレイできることを確認(「今、できてるぞ!!!」)
- 最終構成: IRリモコン → ESP32(VS838で受信、`color_memory_game_ble.ino`)→ BLE通知 → `game_server.py`(bleak 2.1.1)→ ブラウザ(localhost:8000)
- プロジェクトの当初目標(100均LEDライトのリモコンで遊ぶリズムゲーム)が完全動作に到達。ペアリング不要・WiFi不要・自動再接続つき
- 残タスク: 特になし。気が向いたら site/ の制作記事にBluetooth版への変遷を追記するのもあり

## 2026-07-27 - BLE接続の実機確立に成功(残っていた2つのバグを修正)
- ユーザーのターミナルでもBLEスキャンが無反応だった問題を調査。切り分けの結果、権限は「許可」済みなのにハングしており、犯人は2つと判明:
  1. **bleak 3.0.2 のバグ**: macOSでスキャンが永久に固まる(素のCoreBluetoothは正常动作を確認)。`bleak==2.1.1` にダウングレードで解消。README のインストール指示を `pip install flask "bleak<3"` に変更し、サーバー起動時に3.x検出で警告を出すようにした
  2. **ファームの広告パケット構成ミス**: 128bit サービスUUID(18B)+名前(17B)が31Bの広告枠に収まらず、デバイスがスキャンに全く出てこなかった。広告にはUUIDのみ、名前はスキャン応答に分離して解決(`start=OK` をシリアルで確認)
- サーバー側のスキャンも名前でなく**サービスUUIDで探す**方式に堅牢化(名前はフォールバック)
- 修正版ファームは実機に書き込み済み。実サーバーで「[BLE] 接続しました — リンク正常」を確認、20秒以上安定
- 現在の状態: **バックグラウンドでサーバー起動中・BLE接続確立済み**。ブラウザで http://localhost:8000/ を開いてリモコンのONを押せば遊べる状態。このサーバーを止める場合は `lsof -ti :8000 | xargs kill`
- 次にやること: 通しプレイ確認(ONを押してゲームが始まるか)

## 2026-07-27 - Bluetooth ClassicからBLEへ全面切り替え(SPP不安定問題の根本解決)
- 決定的な切り分け: ESP32をUSB経由でリセットして幽霊接続の可能性を排除した直後でも、サーバーが何度ポートを開き直してもRFCOMM(SPPのデータ通路)が確立しなかった(「ポートを開きました→8秒無音→張り直し」の無限ループ)。**現行macOSのBluetooth Classic (SPP)サポート自体が不安定**で、今日接続に成功したのは2回だけと判明。ポートの開き直しでは解決不能と判断
- 対応: 通信方式をBLE (Bluetooth Low Energy) に全面切り替え。①新ファーム `firmware/color_memory_game_ble/`(NimBLE-Arduino 2.5.0、Nordic UART互換UUID、通知でボタン名送信、切断時は自動で再アドバタイズ)を作成、**arduino-cli upload(115200bps、921600は失敗)で実機に書き込み済み**。シリアルで「BLE advertising as: ColorMemoryGame」を確認 ②`game_server.py` のSPP受信(bt_reader/pyserial)をBLE受信(ble_reader/bleak 3.0.2)に置き換え。ペアリング不要・自動検出・自動再接続。ログのラインバッファリング修正も適用済み
- BLEのメリット: macOSが第一級サポート(CoreBluetooth)、ペアリング不要、切断検知はBLEスタック内蔵(supervision timeout)なのでアプリ側ハートビート不要、フラッシュも89%→55%に減少
- 未検証の一点: この裏側シェル環境にはmacOSのBluetooth権限が無い(ダイアログを出せない)ため、PC側のBLE接続だけは実機確認できていない。**ユーザーが自分のターミナルから `python3 pc_game/game_server.py` を起動し、初回のBluetooth許可ダイアログを「許可」すれば繋がるはず**
- README.mdをBLE構成に更新(ペアリング手順を削除、NimBLE-Arduinoライブラリ追記、SPP版は旧版として残置)
- 次にやること: ユーザーが自分のターミナルでサーバー起動 → Bluetooth許可 → 「リンク正常」ログ確認 → 通しプレイ

## 2026-07-27 - 幽霊接続問題を双方向ハートビートで解決(Bluetooth安定化の完成形)
- ユーザーのサーバーログで新事実: 「ポートを開きました」→8秒無音→「張り直します」の無限ループになっており、PINGすら届いていなかった
- 真因=**ESP32側の幽霊接続**: サーバーをCtrl+Cで止めてもESP32に切断通知が届かないことがあり、ESP32は旧接続(1台しか持てない)を保持したまま新しい接続を拒否し続ける。macOS側はポートを開けてもデータ通路(SPP)が確立しない
- 対策=ハートビートを双方向化: ①サーバー側からも2秒ごとに `PING\n` を送信(write_timeout=2秒付き) ②ESP32は「PCから8秒間何も届かない接続」を幽霊とみなして `SerialBT.disconnect()` で自分から切断し、次の接続を受け付ける(新規接続には8秒の猶予)。これでどちら側がどんな止まり方をしても最大20秒程度で自動復旧する
- 検証: ptyテストで双方向PING+ボタン受信を確認、ファームもコンパイル確認済み(89%)
- ユーザー側の残作業: ①ESP32に更新版 `color_memory_game_bt.ino` を書き込み(これで現在残っている幽霊接続もリセットされる) ②サーバーをCtrl+C→再実行 ③ログに「リンク正常、リモコン操作OKです」が出るのを待つ(書き込み直後は1〜2分かかることあり) ④リモコンのONでプレイ開始
- 次にやること: 通しプレイ確認

## 2026-07-27 - 「ESPは受信してるのにPCに届かない」の調査 → 原因は書き込み直後の接続確立待ちだった
- ユーザー報告(サーバーログ+Arduinoシリアルモニタ付き): ESP32はIRを正常受信しているが、PC側に何も届かない
- 実機調査で判明したタイムライン: サーバー起動16:02:12(ESP32はファーム書き込み直後で再起動中)→ ユーザーのボタン連打は16:03:25〜30 → Bluetooth接続成立は16:03:52(連打の後)。つまり**書き込み直後の1〜2分はBluetooth確立待ちで、その間の入力が全部落ちていただけ**。接続成立後は20秒監視してリンク断なし=PINGハートビートが届き続けており、パイプは健全と確認(PINGが来なければサーバーは8秒ごとに張り直すため接続がフラップするはずだが、しなかった)
- 分かりにくさの解消としてサーバーログを改善: ①ポートを開いた時点では「信号待ち...」と表示 ②実際に最初のデータ(PING含む)を受信した時点で「リンク正常、リモコン操作OKです」と表示 ③接続失敗時のメッセージに「起動直後は1〜2分かかることがある」の注記を追加。ptyテストで動作確認済み
- 現在の状態: リンクは生きているので、リモコンのONを押せばそのまま遊べるはず。ログ改善は次回サーバー再起動時に反映
- 次にやること: ユーザーの通しプレイ確認

## 2026-07-27 - Bluetooth「1回しか反応しない」問題を修正(ハートビートによる半死に接続の検知)
- ユーザー報告: Bluetooth接続はでき、ESP32のOLEDには押したボタンが表示されるが、ONで一度ゲームが始まった後はサイト(ゲーム画面)が反応しなくなる
- 実機調査で確定: 新サーバー(PID確認済み)はポート8000とBluetoothポートを正常に保持したまま、一度ONを受信してゲーム開始→idle復帰後、以降のボタンが一切届いていなかった(judgment_seq=0のまま)。原因は**Bluetooth接続の半死に**: ESP32の電源入れ直し等でリンクが切れても、macOS側にはエラーが上がらず readline が永遠に空を返すだけになるため、再接続のきっかけが来ない
- 対策=死活監視(ハートビート): ①ファーム `color_memory_game_bt.ino` が接続中2秒ごとに `PING` を送信 ②サーバー側 `bt_reader` は8秒無音ならポートを閉じて開き直す(RFCOMMが張り直される)。PINGはゲームロジックには流さない
- 検証: pty(擬似シリアル)でPING/ボタン/無音→自動張り直し→復帰の一連をテストしALL OK。ファームもコンパイル確認済み(89%)
- 注意: ファームとサーバーは**セットで更新が必要**(旧ファーム+新サーバーだとPINGが来ないため8秒ごとに張り直しを繰り返す)
- ユーザー側の残作業: ①ESP32に更新版 `color_memory_game_bt.ino` を書き込み直す ②起動中の `game_server.py` をCtrl+Cで止めて再実行 → 通しプレイ確認

## 2026-07-27 - Bluetooth接続対応(WiFi不要化)
- ユーザーの依頼「ESP32を起動したらBluetoothだけでPCとつながるように」に対応。WiFiルーター・IPアドレス設定(wifi_config.h)が一切不要になる構成に変更
- 新ファームウェア `firmware/color_memory_game_bt/color_memory_game_bt.ino` を作成: Bluetooth Classic (SPP、デバイス名「ColorMemoryGame」)でボタン名を1行ずつ送信。OLEDに接続状態(Waiting for PC... / PC connected!)を表示。IRコードは★確定版をそのまま使用。標準パーティションでコンパイル確認済み(フラッシュ89%)
- `pc_game/game_server.py` にBluetooth受信スレッドを追加: `/dev/cu.ColorMemoryGame*` を自動検出してpyserialで読み取り、HTTPと同じ `handle_button()` に流す。未検出・切断時は3秒おきに再試行(ESP32の電源ON/OFFに追従)。HTTP経路(/button)はブラウザのクリックテストとWiFi版のために残置。pyserial未導入でも起動可能(BT受信のみ無効)
- PCに pyserial 3.5 をインストール済み。テストクライアントでBT待機ログ・HTTP経路・handle_button直呼びの全経路の動作確認済み
- README.md をBluetooth構成を主として書き換え(mermaid図、セットアップ手順=書き込み→ペアリング→サーバー起動、WiFi版は折りたたみの代替手順に格下げ、リポジトリ構成)
- ユーザー側の残作業: ①ESP32に `color_memory_game_bt.ino` を書き込み ②Macのシステム設定>Bluetoothで「ColorMemoryGame」をペアリング ③起動中の `game_server.py` を再起動(オーバーレイ修正も同時に反映される) ④ブラウザ再読み込み → 通しプレイ確認
- 次にやること: 上記の通しプレイ確認。問題なければWiFi版起動時の持ち越しタスク(PC_SERVER_HOST設定)は不要になる

## 2026-07-27 - ステージ開始時のオーバーレイが半透明で、裏の16拍コンベアが透けて見えるバグを修正
- ユーザー報告: 「Stage N」の暗転表示中に、裏でもう16拍のノーツ(太鼓の達人風コンベア)が流れ始めているのが透けて見えて分かりにくい
- 原因: `pc_game/templates/index.html` の `#introOverlay` の背景が `rgba(10, 11, 14, 0.85)`(不透明度85%)だったため、裏のコンベアが薄く透けていた。仕様上、コンベア自体はサーバーの `stage_start_time` に同期して裏で先に構築・スクロールを開始する設計(通信遅延分のズレを避けるため)なので、コンベア自体を止める修正ではなく、オーバーレイを完全不透明の `#0a0b0e` に変更して裏を完全に隠す形で対応
- 動作確認: 既存の `game_server.py` が既にポート8000で起動中(おそらくユーザーが実機テスト中)だったため、二重起動はせず触らなかった。Flaskはdebug=Offでテンプレート自動リロードしないため、この修正を反映するには **サーバーの再起動が必要**
- ユーザー側の残作業: 起動中の `game_server.py` を再起動 → ブラウザ再読み込みで確認
- 次にやること: 前回からの持ち越し — PCのIP確認 → `wifi_config.h` の `PC_SERVER_HOST` 更新 → 通しプレイ確認

## 2026-07-27 - ★確定: Purple1/Pink/Purple2のIRコード対応、これ以上変更しないこと
- ユーザーが下記の対応を明示的に「今の設定が最高。覚えて」と確認。直前のe05b7feコミットの内容と完全一致していることを確認済み
- **確定版(以後このセッションでもこの対応を疑わない):**
  ```
  {"Purple1", 0x1FE906F}
  {"Pink",    0x1FEF807}
  {"Purple2", 0x1FE708F}
  ```
- 経緯: 7/21の実機シリアルモニタ取得値が最初から正しく、7/27に2回「修正」して余計にずれさせた後、この最初の値に復元(e05b7fe)。以後もしIRコードのずれ報告があっても、まずこの3つの値を疑う前に `pc_game/game_server.py` の画面レイアウト(名前→row/col)側を疑うこと
- 次にやること: ESP32への書き込み・game_server.py再起動・ブラウザ再読み込み後の通しプレイ確認(前回からの持ち越し: PCのIP確認 → `wifi_config.h` の `PC_SERVER_HOST` 更新)

## 2026-07-27 - 【真の原因判明】Purple1/Pink/Purple2ずれ問題を解決、IRコードを元の対応に復元
- 「Purple1を押すとOLEDにPurple2と出る」「Pinkを押すとPurple1と出る」というユーザーの実機報告から逆算し、真の原因を特定: **IRコードは7/21にシリアルモニタで取得した元の対応(Purple1=0x1FE906F / Pink=0x1FEF807 / Purple2=0x1FE708F)が最初から正しかった**。本当のバグは `pc_game/game_server.py` の画面レイアウトで、この3色の名前が誤った位置(Purple2が上・Pinkが下)に割り当てられていたこと。それをファームウェアのコード側を回して直そうとしたため、2回の「修正」(コミット c59ba03, 9886640)がどちらも新たなずれを生んでいた
- 対応: 両ファームウェアのIRコードを元の対応に復元(コンパイル確認済み)。game_server.py は前回修正済みのレイアウト(読み順: Purple1=右列2段目 / Pink=右列3段目 / Purple2=右列4段目、実物写真 site/images/remote.jpg と照合済み)を維持
- ユーザー側の残作業: ①ESP32へ `color_memory_game_wifi.ino` を再書き込み ②`game_server.py` を再起動 ③ブラウザのページを再読み込み。この3つが揃えば Purple1押下→OLED「Purple1」→画面の右列2段目が光る、で一致するはず
- 次にやること: 上記の反映後に通しプレイ確認(前回からの持ち越し: PCのIP確認 → `wifi_config.h` の `PC_SERVER_HOST` 更新も未完なら合わせて)

## 2026-07-27 - Purple1/Pink/Purple2のIRコード再訂正(実機確認による最終版)
- 直前のエントリで修正した3色の対応がまだ違っていたとユーザーから訂正。最終的な正しい対応は Purple1=0x1FEF807 / Pink=0x1FE708F / Purple2=0x1FE906F
- WiFi版 `color_memory_game_wifi.ino` はユーザーが直接修正済み。スタンドアロン版 `color_memory_game.ino` の COLORS[] を同じ対応に揃えた。`pc_game/game_server.py` はIRコードを持たず色名・配置も不変のため変更なし
- 両ファームウェアとも arduino-cli でコンパイル確認済み。GitHubへプッシュ済み
- 次にやること: 前回の続き — PCをモバイルWiFiルーターに接続してIP確認 → `wifi_config.h` の `PC_SERVER_HOST` 更新 → `game_server.py` 起動 → ESP32へWiFiブリッジ版書き込み → 通しプレイ確認

## 2026-07-27 - Purple1/Pink/Purple2のIRコード対応を全ゲームコードで修正
- ユーザーから「これが正しい並び」としてリモコン12色ボタンの正しいIRコード対応が提示された(Purple1=0x1FE708F / Pink=0x1FE906F / Purple2=0x1FEF807。この3つのラベル付けが従来ずれていた)
- WiFi版 `firmware/color_memory_game_wifi/color_memory_game_wifi.ino` は既に修正済み(未コミット状態)だったため、残りを揃えた: ①スタンドアロン版 `firmware/color_memory_game/color_memory_game.ino` の COLORS[] の3コードを入れ替え(RGB値は色名どおりなので据え置き) ②`pc_game/game_server.py` の COLORS を読み順(Red→Green→Blue1→…→Purple2)に並べ替え、右列(col 2)の名前を row3=Purple1 / row4=Pink / row5=Purple2 に修正(hexは物理ボタンの見た目なので位置に据え置き)
- site/index.html のIRコード表は赤・緑・青・黄のみ掲載で今回の3色を含まず、修正不要と確認
- 両ファームウェアとも arduino-cli でコンパイル確認済み。game_server.py も12色・重複なしのサニティチェック済み
- 次にやること: 前回の続き — PCをモバイルWiFiルーターに接続してIP確認 → `wifi_config.h` の `PC_SERVER_HOST` 更新 → `game_server.py` 起動 → ESP32へWiFiブリッジ版書き込み → 通しプレイ確認

## 2026-07-27 - 制作記事の公開ページ(site/)を作成、Vercel公開準備
- 制作記録をVercelで公開したいという依頼に対応。プランモードで構成を確認(素のHTML+CSS 1ページ / 動画はリポジトリ内mp4 / このリポジトリ内に site/ / Amazonリンクはプレースホルダ / 図はSVGで自作)し、承認を得て実装
- `site/index.html` + `site/style.css` を新規作成。構成: ヒーロー → デモ動画(videos/demo.mp4 プレースホルダ、poster付き) → 伝えたいこと(フィジカルAI) → きっかけ(講義のガチャロック工作) → 100均は部品の宝庫 → なぜLEDライト+リモコンか → 分解 → 機材紹介(Amazonリンク準備中表記) → 作り方(AIとの共同作業、安全面の注意書き、IRコード表、詰まりと解決) → まとめ+リポジトリリンク
- 自作SVG図3点を埋め込み: 全体構成図(リモコン→赤外線→ESP32→WiFi→PC)、配線図(VS838 OUT→GPIO27 / GND / 3V3)、ゲームルール図(16拍レーン)。ダークモード対応(CSS変数)
- 写真8枚を `sips` で長辺1600pxに縮小し `site/images/` に配置(計約3.5MB)。元のIMG_*.jpegはコミットせず .gitignore に追加。追加予定写真(パッケージ入り状態、ジャンパ線)用の点線プレースホルダ枠を設置
- ヘッドレスChromeで全セクションの表示確認済み(画像・SVG図・レイアウト・フッターまで正常)
- 機密情報チェック: SESSION_LOG.md 内のメールアドレス2件とWiFi SSIDをマスクしてからコミット(公開リポジトリのため)
- 【同セッション追記】「画像がデカすぎ」「READMEに使い方がない」というフィードバックを受けて更新: ①デザイン全面刷新(テーマ=リモコンの12色+OLEDシアン。ビートストリップ、セクション頭の色チップ、モノスペースのラベル、ダークはOLED風の黒地) ②写真は2枚組グリッド+4:3クロップ+クリックで原寸表示に変更、画像も再圧縮(3.5MB→2.3MB) ③README.md を新規作成(mermaid構成図、必要なもの、配線表、PC/ESP32セットアップ手順、IRコードの調べ方、遊び方、リポジトリ構成) ④長いURLの折り返し修正。ライト/ダーク/モバイル幅の表示確認済み
- 【同セッション追記2】ユーザーから素材が届き反映: ①デモ動画(IMG_6493 2.MOV、174MBの4K HEVC縦動画)を ffmpeg で720p H.264に圧縮(4.1MB)して `site/videos/demo.mp4` に配置、12秒地点からポスター画像も生成 ②パッケージ写真2枚(リモコンライト税込330円・人感センサーライト税込330円)と、はんだ付け後の写真を記事に追加(プレースホルダの置き換え+STEP 2に「中学生以来のはんだ付けも100均道具とYouTubeでできた」の段落を新設) ③.gitignore に IMG_*.MOV を追加。残るプレースホルダはジャンパー線の写真のみ
- 【同セッション追記3】ジャンパー線(オス-メス)の写真が届き、機材セクションの最後のプレースホルダを差し替え。これで記事内のプレースホルダは全て解消。.gitignore はリポジトリ直下の撮影ファイル(/*.jpeg, /*.jpg, /*.MOV, /*.mov)を除外する形に拡大
- 【同セッション追記4】ユーザー提供のAmazonリンク4本(ESP32/ブレッドボード/ジャンパー線/PIXELA WiFi USB)を機材カードに反映。「リンク準備中」表記と pending スタイルを削除。全リンクが amazon.co.jp へ301リダイレクトすることを確認済み
- 【同セッション追記5】写真の表示方法を変更: 4:3トリミング(object-fit: cover)をやめ、常に画像全体が見える表示(max-height 340px、単独表示は380px、中央寄せ)に。キャプションも中央揃えに統一
- 【同セッション追記6】Vercelデプロイ完了(https://sensor-infrared.vercel.app/)を受けて最終仕上げ: ①Playwright(pip導入)で公開URLをスマホ390px/PC900px・ライト/ダークで全画面検証、横はみ出しなしを確認 ②「変な改行」2種を修正 — HTMLソース内の文中改行81箇所を結合(日本語文中に半角スペースが出る問題)、`word-break: auto-phrase` を見出し/リード/キャプション/リストに適用(「電/子部品」「ゲームオーバ/ー」等の不自然な折り返し解消) ③OGPメタタグ追加(og:title/description/url/image、twitter:card) ④READMEに公開URLを反映。これで最終版
- プロジェクト完了。公開URL: https://sensor-infrared.vercel.app/(以後の更新は git push で自動デプロイ)

## 2026-07-27 - フォルダの共有状況の確認(コード作業なし)
- 「このフォルダは共有されているか」という質問に対応: GitHubリポジトリ https://github.com/KeitoKuramochi/sensor_infrared に**パブリック(公開)**で共有されており、ローカルmainはorigin/mainと同期済み(d3c22caまでプッシュ済み)と確認
- ローカルのみで未共有のもの: 未コミット変更(.claude/settings.json, .gitignore, SESSION_LOG.md)と未追跡ファイル(IMG_6308〜6315.jpeg の写真8枚、firmware/, pc_game/)
- iCloudのDesktop同期はオフ、Dropbox等の同期もなし。GitHub以外の共有経路はないことを確認
- リポジトリが公開設定である点を注意喚起(写真コミット時の写り込み等)。非公開化したい場合は `gh repo edit --visibility private` で可能と案内
- 次にやること: 前回の続き — PCをモバイルWiFiルーターに接続してIP確認 → `wifi_config.h` の `PC_SERVER_HOST` 更新 → `game_server.py` 起動 → ESP32へWiFiブリッジ版書き込み → 通しプレイ確認

## 2026-07-27 - ログイン中アカウントの確認とGitメール変更(コード作業なし)
- 現在どのアカウントでログインしているかの質問に対応: Git設定は KeitoKuramochi / 個人Gmail、GitHub CLI (gh) は KeitoKuramochi でログイン済み、Claude Code は大学メールでログイン中と確認(アドレスは公開リポジトリのためログには記載しない)
- ユーザーの希望で名義を大学メールに統一: 大学メールは既存の KeitoKuramochi GitHub アカウントに追加済みのため gh は変更不要。Git のグローバル user.email を大学メールに変更(ユーザーが `!` コマンドで実行、反映確認済み)。user.name は KeitoKuramochi のまま
- プロジェクトのコード・配線作業は今回なし。現在の状態は 2026-07-21 エントリから変わらず
- 次にやること: 前回の続き — PCをモバイルWiFiルーターに接続してIP確認 → `wifi_config.h` の `PC_SERVER_HOST` 更新 → `game_server.py` 起動 → ESP32へWiFiブリッジ版書き込み → 通しプレイ確認

## 2026-07-27 - Claude Codeのアカウント切り替え方法の質問対応(コード作業なし)
- Claude Codeを別のメールアドレスのアカウントでログインし直す方法について質問を受け、`/logout` → `/login` の手順(ブラウザ認証時に「別のアカウントを使用」を選ぶ、ログイン情報は `~/.claude` 配下でマシン単位に保存される等)を案内
- プロジェクトのコード・配線作業は今回なし。現在の状態は前回エントリ(2026-07-21)から変わらず
- 次にやること: 前回の続き — PCをモバイルWiFiルーターに接続してIP確認 → `wifi_config.h` の `PC_SERVER_HOST` 更新 → `game_server.py` 起動 → ESP32へWiFiブリッジ版書き込み → 通しプレイ確認

## 2026-07-21 - 実機配線・IRコード確定・アーキテクチャ変更(PC+WiFiブリッジ方式)
- 実機検証: OLEDが表示されない不具合を、自作I2Cスキャナースケッチ(`firmware/oled_i2c_scan/`)で診断し、SDA=21/SCL=22(ESP32標準I2Cピン)と判明。`color_memory_game.ino`に反映し、OLED表示確認済み
- リモコンの実際のIRコードをシリアルモニタから取得し、ON/OFF/12色ボタン全てのコードを`color_memory_game.ino`の`COLORS[]`・`BTN_ON_CODE`・`BTN_OFF_CODE`に反映済み(コンパイル確認済み)
- D1(RGB LED、CHS005RGB-02基板から流用)のVCC/GND/DIN配線がテスターなしでは特定できず難航。ユーザーがnote.comの分解記事(https://note.com/tomorrow56/n/nb432087b67fd 等)を発見し、受信部ICが「VS838」と判明。データシート(PDF)を取得しピン配置を確認: ドーム正面から見て左からOUT/GND/VCC。この情報でIR受信部の配線は確定・動作確認済み(USB給電なしでもONボタンでゲーム開始することを確認)。D1のLED配線は依然未解決(テスターかWS2812新規購入が必要、保留中)
- ユーザーの意向でアーキテクチャを変更: D1のLED表示が未解決なため、ゲーム画面をPC側に移し、ESP32はIRリモコンのボタンをWiFiでPCに送るだけのブリッジ役にする方式に転換。新規に `pc_game/game_server.py`(Flask、ゲームロジック一式)+ `pc_game/templates/index.html`(ブラウザのゲーム画面)+ `firmware/color_memory_game_wifi/color_memory_game_wifi.ino`(WiFiブリッジ版ファームウェア)を実装。Flask側はテストクライアントで正常動作確認済み(コンパイルも確認済み)
- ユーザーが専用のモバイルWiFiルーター(SSIDは非公開、wifi_config.h に設定済み)を用意し、ESP32用の`wifi_config.h`にSSID/パスワードを設定済み(このファイルはgitignore対象)。PC側がまだこのWiFiに接続されておらず、`PC_SERVER_HOST`はプレースホルダのまま
- 現在の状態: D1配線以外は一通り実装・確認済み。PCがモバイルWiFiルーターに接続され次第、IPアドレスを`wifi_config.h`の`PC_SERVER_HOST`に反映すれば動作確認に進める状態
- 次にやること: PCをモバイルWiFiルーターに接続 → `ipconfig getifaddr en0`等でIP確認 → `PC_SERVER_HOST`更新 → `pc_game/game_server.py`起動 → ESP32に`color_memory_game_wifi.ino`書き込み → ブラウザ(`http://localhost:5000/`)とリモコンで通しプレイ確認。D1のLED配線はテスター入手後に再開

## 2026-07-20 19:30 - color_memory_game.ino のコンパイル検証・バグ修正
- arduino-cli (esp32:esp32コア導入済み) を使い、IRremoteESP8266 / Adafruit NeoPixel ライブラリを追加インストールして `firmware/color_memory_game/color_memory_game.ino` を実機なしでコンパイルチェック
- コンパイルエラーを発見: `enum GameState` の `INPUT` がArduinoコアの `#define INPUT 0x01` (pinMode用マクロ)と衝突していた。`INPUT` → `WAITING_INPUT` にリネームして解消、再コンパイルが通ることを確認済み
- ついでに `firmware/presence_light/presence_light.ino` も wifi_config.example.h を一時的にコピーしてコンパイル確認(問題なし、確認後はコピーしたファイルを削除済み)
- 現在の状態: 2つのスケッチともコンパイルは通る。実機での配線・書き込み・実際のIRコード取得はまだ未実施
- 次にやること: 実機に配線して書き込み、シリアルモニタで12色ボタン+ON+OFFの実コードを確認してcolor_memory_game.inoに反映。OLEDのSDA/SCLピンも実機で確認。

## 2026-07-20 19:10 - 方向転換: 色記憶ゲーム(Simon風)を実装
- 当初の人感センサー構想から、ユーザーの発案で「ESP32+リモコン(12色ボタン)+パック基板流用のWS2812 LED/IR受信部+OLED」を使った色記憶ゲーム(Simon Says方式)に方向転換
- Plan modeでゲーム仕様(IDLE/SHOWING/INPUT/GAME_OVERの状態遷移、白は出題せず12色のみ等)を固め、`/Users/kuramochikeito/.claude/plans/18-misty-hamming.md` にプラン保存
  - プランファイルの保存先がプロジェクト外(`~/.claude/plans/`)のため、当初 `.claude/settings.json` のフォルダ外書き込み禁止フックにブロックされた。ユーザーの指示で `~/.claude/plans/` だけをフックの例外に追加(他の安全ルールは維持)
- `firmware/color_memory_game/color_memory_game.ino` を新規実装(presence_light.ino は人感センサー用にそのまま残置)。IR受信→状態機械→WS2812表示→OLED表示のゲームロジック一式を実装。ONで開始、色シーケンスを再生→リモコンの色ボタンで再現→正解でステージ+1、不正解/タイムアウトでゲームオーバー、OFFで中断
- 実装中、色再生の点灯/消灯タイミング(handleShowing)にバグ(消灯時間が機能しない)を発見しその場で修正済み
- 現在の状態: コードは書き上がったが未実機検証。IRコード(COLORS[]のirCode, BTN_ON_CODE, BTN_OFF_CODE)は全てプレースホルダのまま、OLEDのSDA/SCLピン(現在GPIO5/4で仮設定)も未確認
- 次にやること: 実機に配線・書き込みし、シリアルモニタで12色ボタン+ON+OFFの実際のIRコードを確認してコードに反映。OLEDのI2Cピンをボード資料で確認して修正。一通りプレイして動作検証(検証手順はプランファイル参照)

## 2026-07-20 18:20 - 手持ち部品の確認 + 人感検知システムの構想相談
- ユーザーが撮影した写真(IMG_6308〜6312、未コミット・.gitignore対象外の作業用画像)を確認し、手持ち部品を整理: 100均RGB電球の受光/駆動基板(CHS005RGB-02、IR受光部+5050 RGB LED+駆動IC)、ESP-WROOM-32開発ボード(ideaspark製、OLED付き)、18ボタンのIRリモコン、UFOキャッチャー景品のスケボー型トイ(豆電球+ボタン電池、あまり活用見込みなし)
- 「リモコンから赤外線を出しっぱなしにして、人が通ったら遮断を検知しWi-Fi経由でPC側の何かを光らせたい」という構想に対し、実現可否とアーキテクチャ案を回答(実装はまだ未着手)
  - リモコンを常時IR送信機として使うのは非現実的(ボタンごとの離散パルス列であり連続ビームに不向き)と説明
  - 代替案: 検知は PIR人感センサー(簡単・確実)、または専用IR LED常時点灯+フォトトランジスタによる自作光電ビームのどちらかを推奨
  - ESP32→Wi-Fi(HTTP/MQTT)でPCに通知→PC側スクリプトが分解済みRGB基板のWS2812系LED(D1)をESP32から直接駆動して光らせる、という構成を提案
- 現在の状態: 方式検討段階。ユーザーからPIR方式か光電ビーム方式かの選択待ち。コードやハードウェア配線の実装はまだ何も行っていない。
- 次にやること: ユーザーの方式選択を受けて、ESP32用Arduino/PlatformIOコードの実装、配線図の検討、PC側受信スクリプト(Python想定)の作成に着手する。

## 2026-07-20 17:55 - 機密情報保護ルールの追加 + 初回プッシュ完了
- git init → リモート https://github.com/KeitoKuramochi/sensor_infrared.git に初回プッシュ完了(main ブランチ)
- 追加指示を受けて、.env / credentials / secrets / 鍵ファイルへの Read/Edit/Write を禁止する PreToolUse フックを追加(Claude 自身も参照不可に)
- .gitignore に機密ファイルパターンを追加、CLAUDE.md に「GitHubへ個人情報・機密情報を絶対に上げない」ルールを明記
- 現在の状態: フォルダ外操作禁止フック・.env参照禁止フック・セッションログ強制フックがすべて .claude/settings.json に設定済みで、リポジトリにプッシュ済み
- 次にやること: `.claude/` が今セッション開始時になかったため、フックを有効化するには `/hooks` を一度開くか Claude Code を再起動する必要あり(ユーザーに案内済み)。実際にセンサー関連のコード作業を始める。

## 2026-07-20 17:40 - プロジェクト初期設定
- このフォルダ (/Users/kuramochikeito/Desktop/hobby/sensor) 以外への Edit/Write を禁止するフックを .claude/settings.json に追加
- セッションごとに本ログの更新を促す/強制する SessionStart・Stop フックを追加
- GitHub リポジトリ https://github.com/KeitoKuramochi/sensor_infrared.git にプッシュする運用ルールを CLAUDE.md に記載
- 次にやること: git init して初回コミット・プッシュ
