KeitoKuramochi/sensor_infrared/firmware/gacha_lock_ble/src_locked.jpg

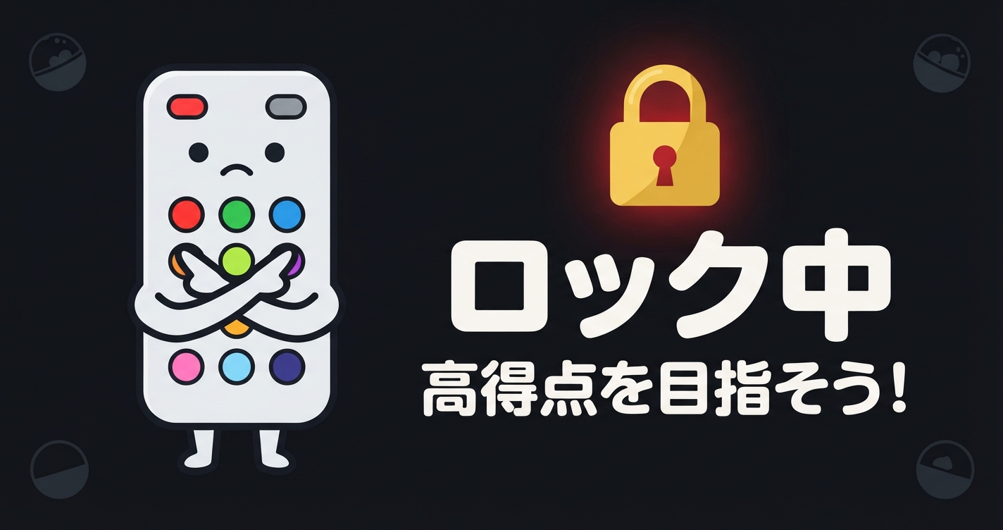
firmware/gacha_lock_ble/src_locked.jpg
