KeitoKuramochi/sensor_infrared/firmware/gacha_lock_ble/src_thanks.jpg

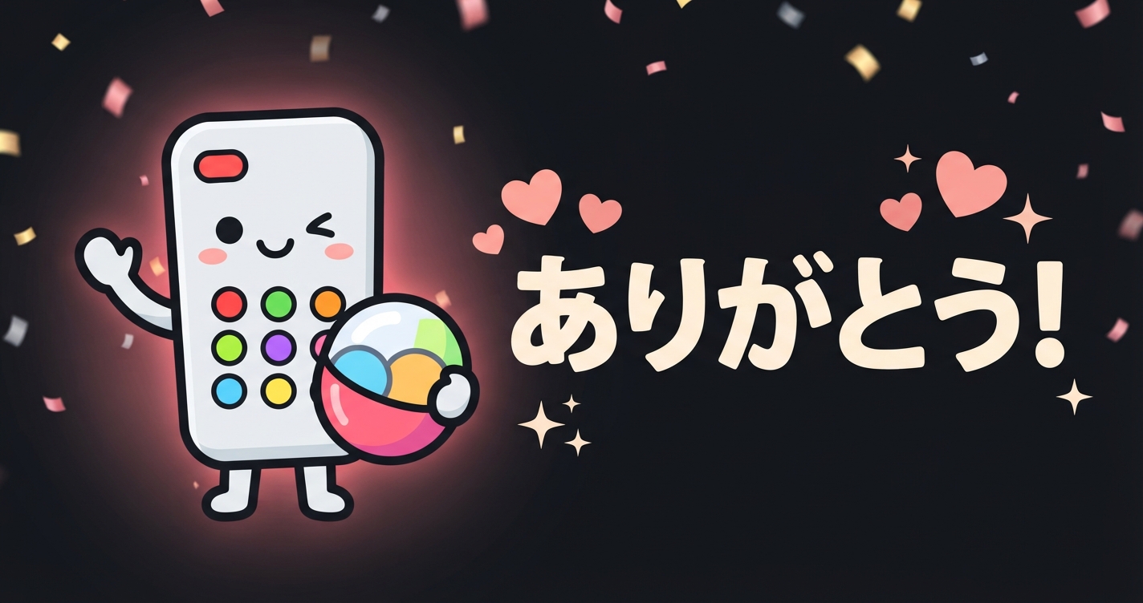
firmware/gacha_lock_ble/src_thanks.jpg
