KeitoKuramochi/sensor_infrared/firmware/gacha_lock_ble/src_unlocked.jpg

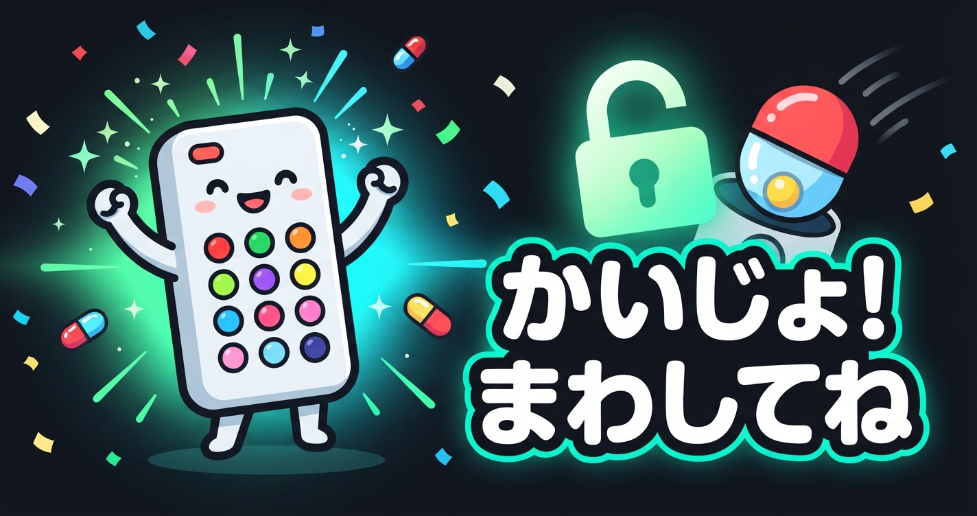
firmware/gacha_lock_ble/src_unlocked.jpg
