KeitoKuramochi/sensor_infrared/site/images/daiso-others.jpg

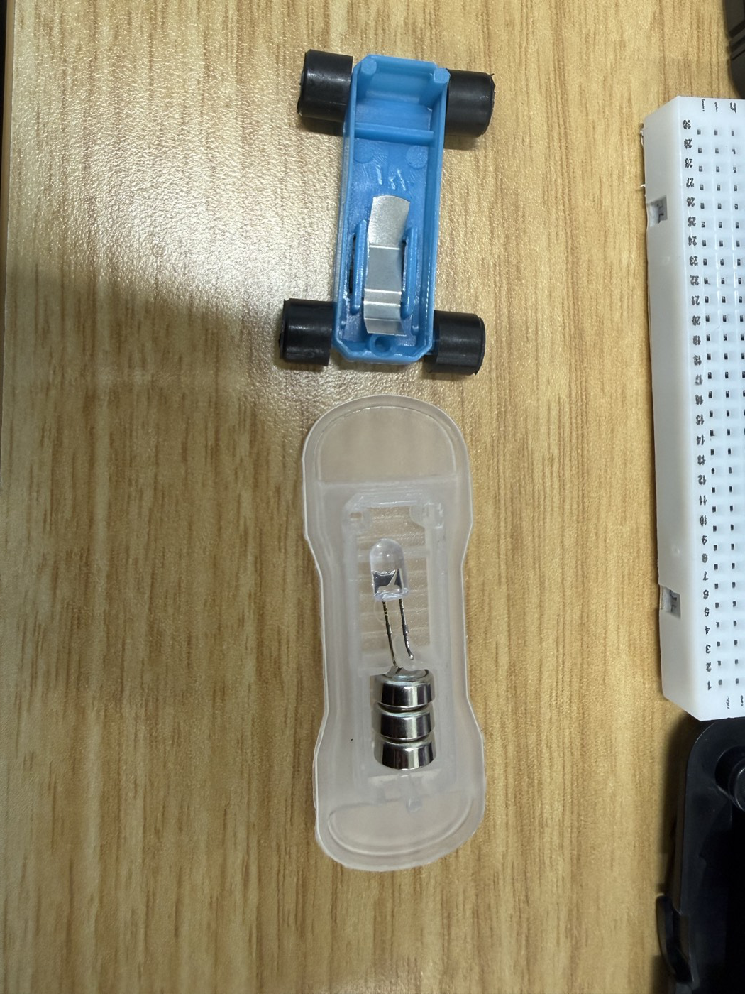
site/images/daiso-others.jpg
