KeitoKuramochi/sensor_infrared/site/images/demo-bt-poster.jpg

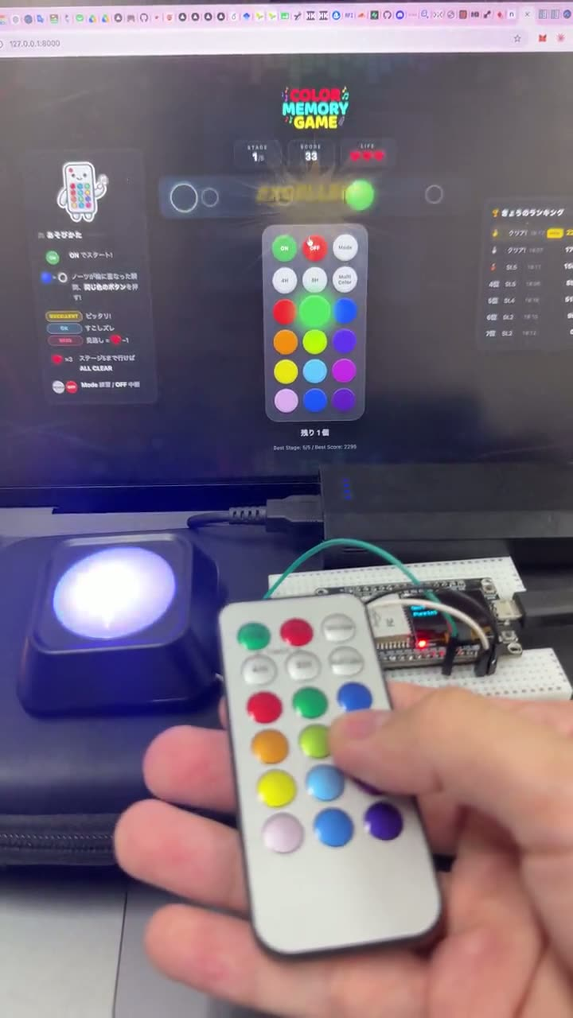
site/images/demo-bt-poster.jpg
