KeitoKuramochi/sensor_infrared/site/images/demo-poster.jpg

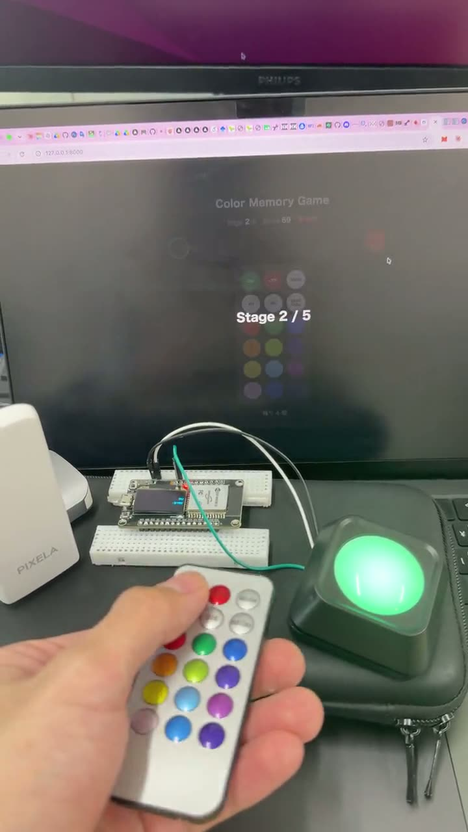
site/images/demo-poster.jpg
