KeitoKuramochi/sensor_infrared/site/images/esp32-oled.jpg

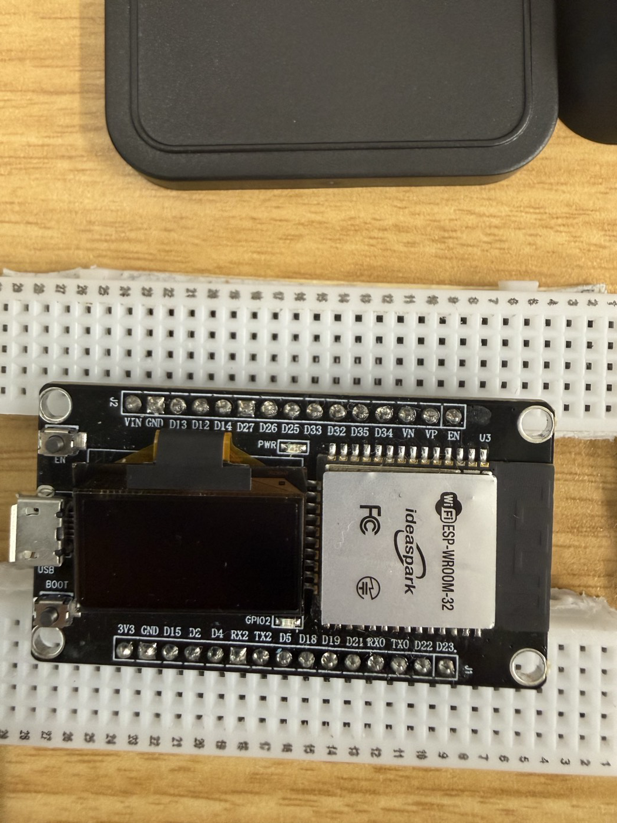
site/images/esp32-oled.jpg
