KeitoKuramochi/sensor_infrared/site/images/game-screen-v2.jpg

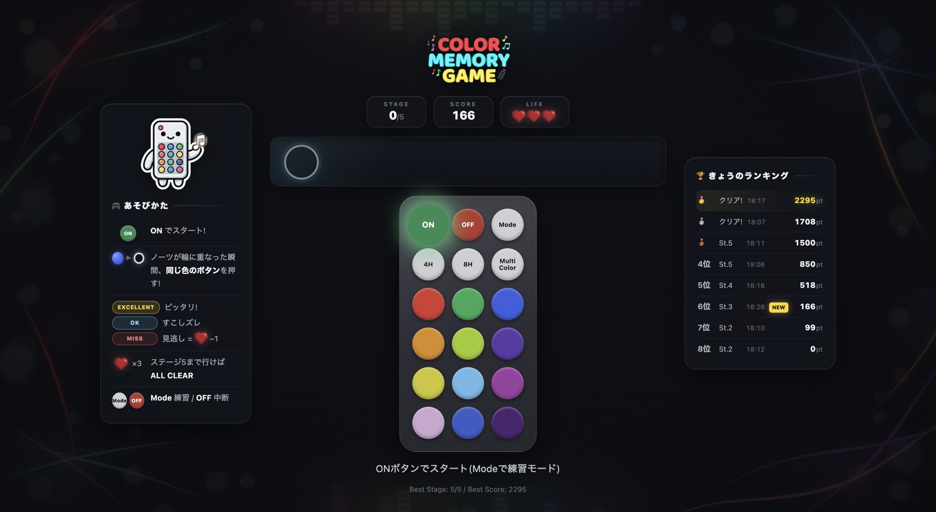
site/images/game-screen-v2.jpg
