KeitoKuramochi/sensor_infrared/site/images/jumper-wires.jpg

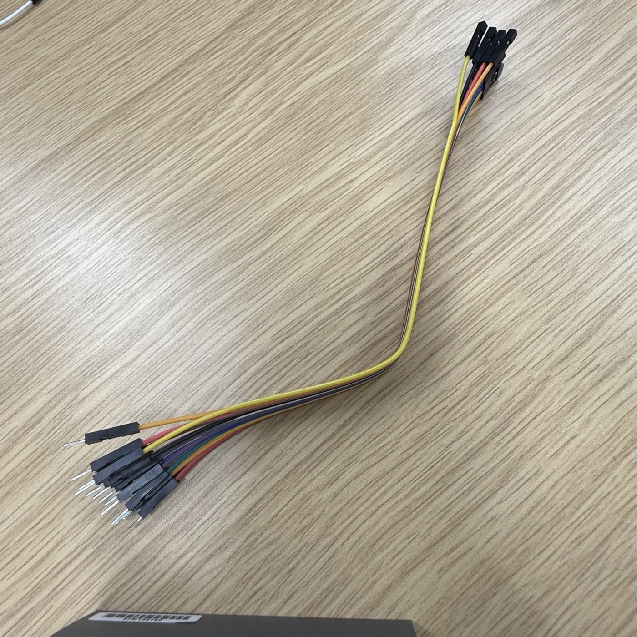
site/images/jumper-wires.jpg
