KeitoKuramochi/sensor_infrared/site/images/led-pcb.jpg

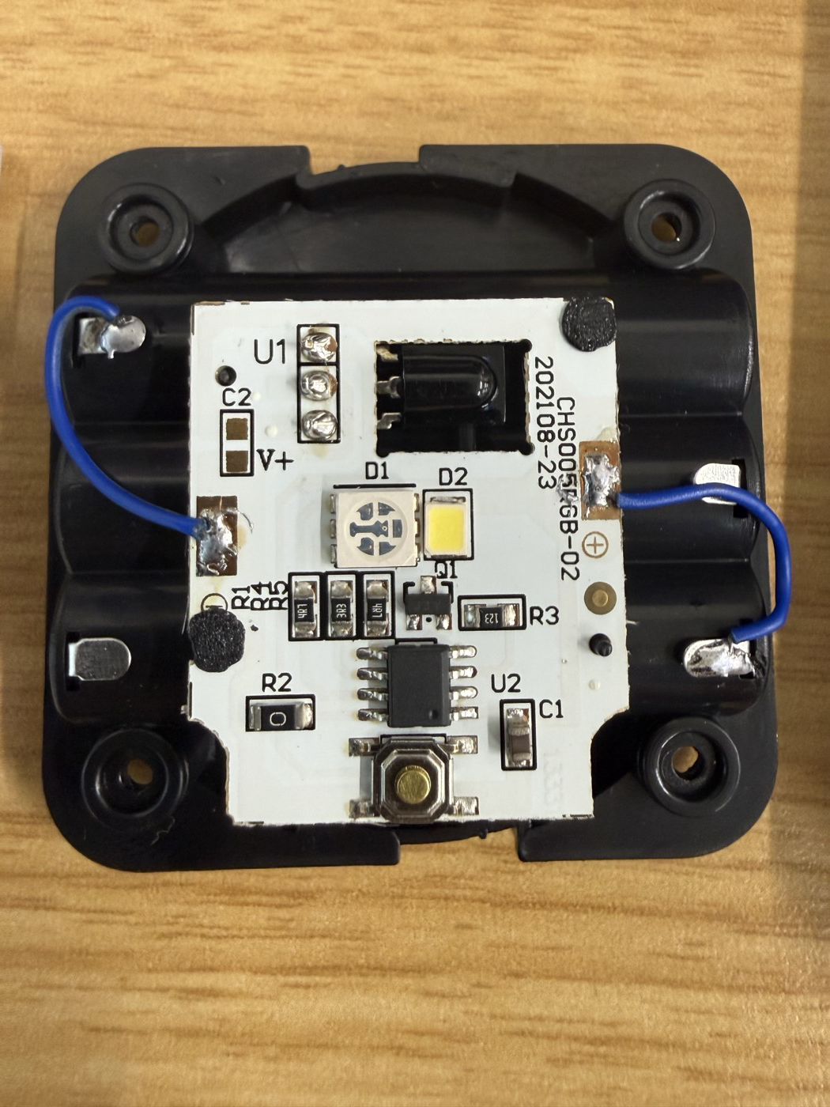
site/images/led-pcb.jpg
