KeitoKuramochi/sensor_infrared/site/images/package-light.jpg

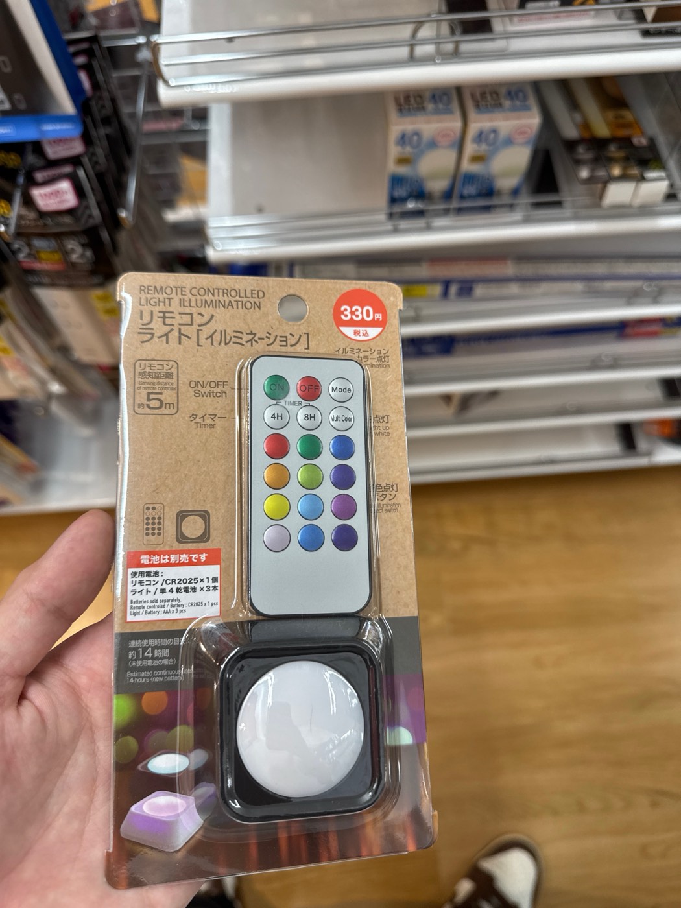
site/images/package-light.jpg
