KeitoKuramochi/sensor_infrared/site/images/package-sensor.jpg

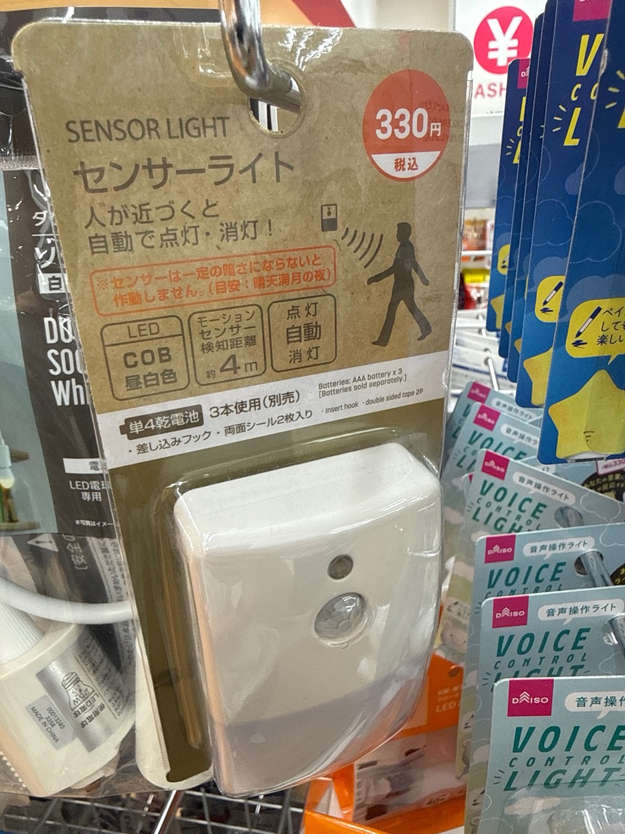
site/images/package-sensor.jpg
