KeitoKuramochi/sensor_infrared/site/images/remote.jpg

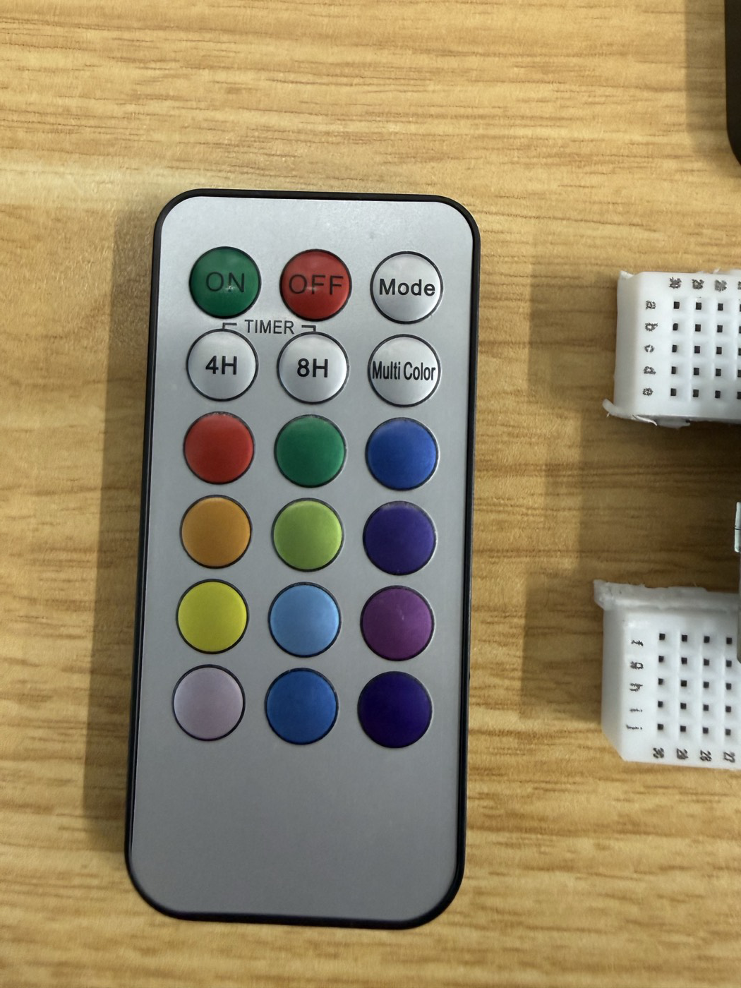
site/images/remote.jpg
