KeitoKuramochi/sensor_infrared/site/images/parts-all.jpg

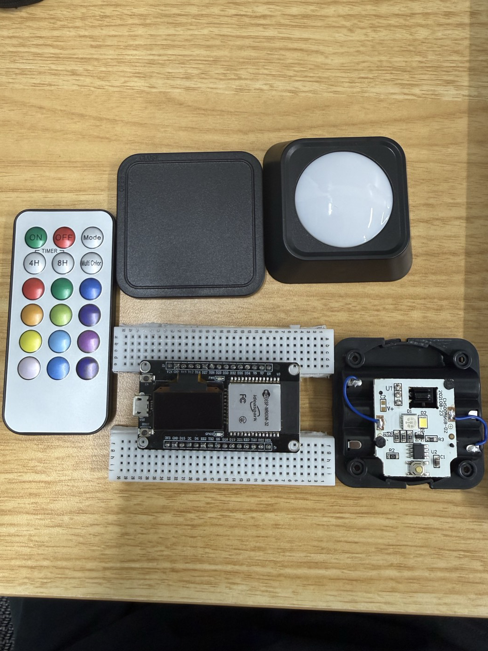
site/images/parts-all.jpg
