KeitoKuramochi/sensor_infrared/site/images/led-pcb-soldered.jpg

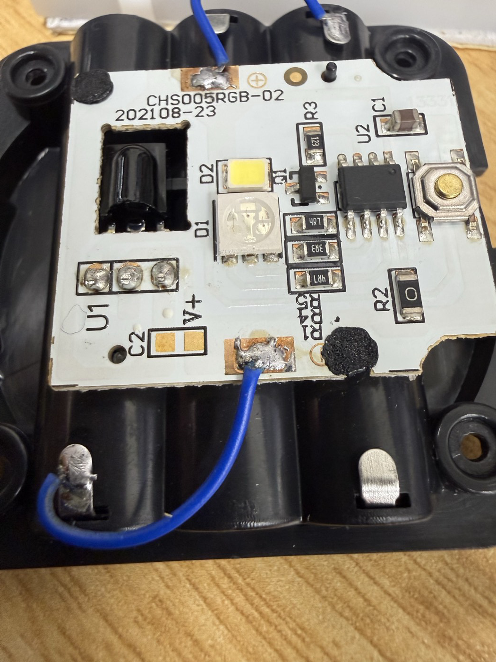
site/images/led-pcb-soldered.jpg
