KeitoKuramochi/sensor_infrared/site/images/soldered-wires.jpg

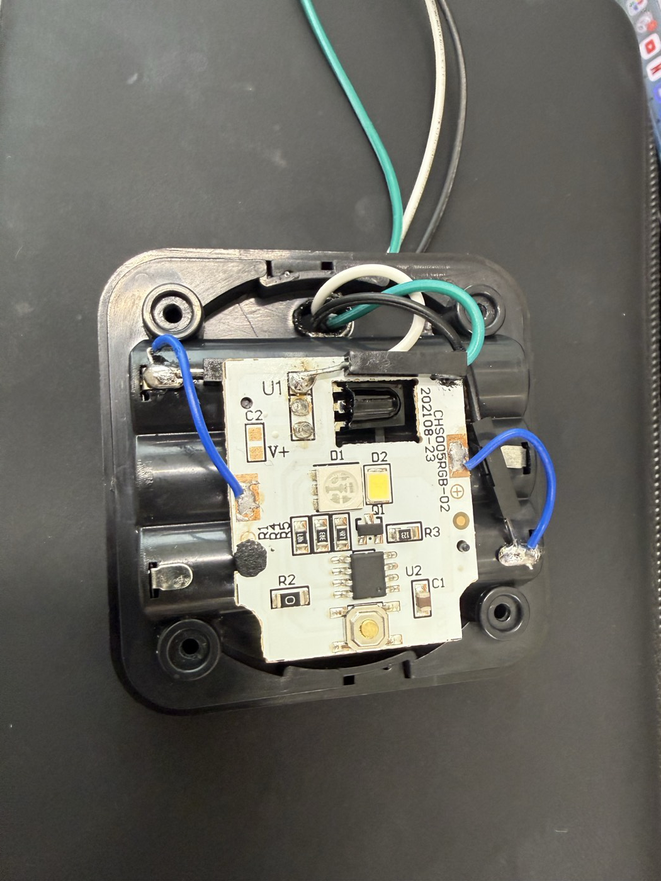
site/images/soldered-wires.jpg
