KeitoKuramochi/sensor_infrared/site/images/wiring-2.jpg

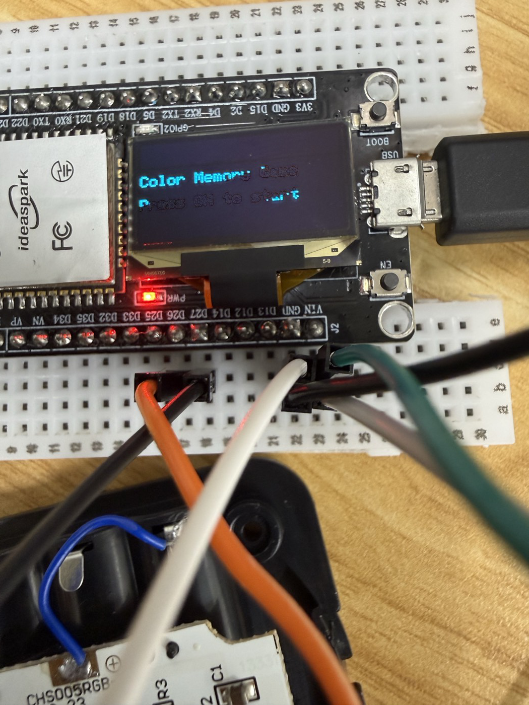
site/images/wiring-2.jpg
