KeitoKuramochi/sensor_infrared/firmware/gacha_lock_wifi/wifi_config.example.h

// このファイルを wifi_config.h という名前でコピーして、実際の値を書き込んでください。
// wifi_config.h は .gitignore 済みなので Git にはコミットされません。

#pragma once

#define WIFI_SSID     "your-wifi-ssid"
#define WIFI_PASSWORD "your-wifi-password"

// PCからは http://<MDNS_NAME>.local/ でアクセスする(macOSは標準で名前解決できる)
#define MDNS_NAME "gacha"
