KeitoKuramochi/sensor_infrared/(commit log)

2026-07-27 Add public build-log site (site/) and commit firmware + pc_game sources
    - site/: 制作記事の公開ページ(素のHTML+CSS、Vercelデプロイ用)。
    デモ動画プレースホルダ、SVG図3点(構成図/配線図/ゲームルール)、
    縮小済み写真8枚、追加写真用プレースホルダ枠を含む
    - firmware/ と pc_game/ のソース一式を公開(wifi_config.h は gitignore 済み)
    - SESSION_LOG.md: メールアドレス・SSIDをマスクし、今回のエントリを追記
    - .gitignore: 元写真 IMG_*.jpeg と __pycache__/ を追加
    Claude-Session: https://claude.ai/code/session_01V4gahEKFZAjr9FPrA2MG1N
2026-07-27 Redesign article site and add README with reproduction steps
    - README.md: 仕組み(mermaid図)、必要なもの、配線表、PC/ESP32の
    セットアップ手順、IRコードの調べ方、遊び方、リポジトリ構成を記載
    - site/: デザイン刷新(リモコンの12色+OLEDシアンをテーマに、
    ビートストリップ/色チップ/モノスペースラベル、ダークモードはOLED風)
    - 写真を2枚組グリッド+クリックで原寸方式にして表示サイズを縮小、
    画像ファイルも再圧縮(計3.5MB→2.3MB)
    - 長いURLの折り返し対応
    Claude-Session: https://claude.ai/code/session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
2026-07-27 Add demo video, store package photos, and soldering story to the article
    - デモ動画: 4K HEVC(174MB)を720p H.264(4.1MB)に圧縮して site/videos/demo.mp4 に配置、
    ゲームプレイ中のフレームをポスター画像に設定
    - パッケージ写真2枚(リモコンライト・人感センサーライト、各税込330円)で
    プレースホルダを置き換え
    - STEP 2 に「中学生以来のはんだ付けも100均道具とYouTubeでできた」の段落と写真を追加
    - .gitignore に IMG_*.MOV を追加(元動画はコミットしない)
    Claude-Session: https://claude.ai/code/session_01V4gahEKFZAjr9FPrA2MG1N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
2026-07-27 Replace last photo placeholder with jumper wire photo
    - 機材セクションにジャンパー線(オス-メス)の写真を追加(プレースホルダ全解消)
    - .gitignore: リポジトリ直下の撮影ファイル(*.jpeg/*.jpg/*.MOV/*.mov)を除外
    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
2026-07-27 Fill in Amazon links for the gear list
    - ESP32/ブレッドボード/ジャンパー線/PIXELA WiFi USB の4カ所に実際の購入リンクを設定
    - 「リンク準備中」表記と pending スタイルを削除
    - 4本とも amazon.co.jp へ正しくリダイレクトすることを確認済み
    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
2026-07-27 Show photos uncropped with a height cap instead of 4:3 crop
    - object-fit: cover による切り抜きをやめ、常に画像全体が見える表示に変更
    - 高さ上限 340px(単独表示は380px)で大きくなりすぎないよう調整、中央寄せ
    - キャプションを中央揃えに統一
    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
2026-07-27 Final polish: fix Japanese line breaks, add OGP tags, link live site
    - HTMLソース内の文中改行81箇所を結合(日本語文中の不要な半角スペースを解消)
    - word-break: auto-phrase を見出し・リード・キャプション・リストに適用
    (「電/子部品」「ゲームオーバ/ー」等の不自然な折り返しを解消)
    - p に text-wrap: pretty を追加
    - OGPメタタグ(og:title/description/url/image、twitter:card)を追加
    - README冒頭に公開URL https://sensor-infrared.vercel.app/ を記載
    - Playwrightで390px/900px・ライト/ダークの全画面検証済み
    Claude-Session: https://clau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
2026-07-27 Fix Purple1/Pink/Purple2 IR code mapping across all game code
    The IR codes for these three buttons were mislabeled. Correct mapping:
    Purple1=0x1FE708F, Pink=0x1FE906F, Purple2=0x1FEF807. Applied to both
    firmware sketches and reordered the PC game's color table to match the
    remote's physical reading order.
    Claude-Session: https://claude.ai/code/session_01UacSw9UMxB1qPVAfyusY8e
    [color_memory_game.ino, color_memory_game_wifi.ino, game_server.py]
2026-07-27 Correct Purple1/Pink/Purple2 IR codes to hardware-verified mapping
    Previous fix was still wrong. Verified on the actual remote:
    Purple1=0x1FEF807, Pink=0x1FE708F, Purple2=0x1FE906F.
    Applied to both firmware sketches; the PC game holds no IR codes
    so it needs no change.
    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
    [color_memory_game.ino, color_memory_game_wifi.ino]
2026-07-27 Restore original IR codes; the real bug was the on-screen layout
    User's OLED report (pressing Purple1 shows Purple2, pressing Pink shows
    Purple1) proves the original 2026-07-21 serial-monitor calibration was
    correct all along: Purple1=0x1FE906F, Pink=0x1FEF807, Purple2=0x1FE708F.
    The actual bug was game_server.py placing these three names in the wrong
    grid slots (fixed in c59ba03); rotating the firmware codes on top of that
    (c59ba03, 9886640) just moved the mismatch around. Firmware codes are now
    back to the hardware-verified originals.
    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
    [color_memory_game.ino, color_memory_game_wifi.ino]
2026-07-27 Log user confirmation: current IR code mapping is final, do not change
    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
2026-07-27 Make stage-intro overlay fully opaque to hide the conveyor starting behind it
    The overlay was 85% opacity, letting the beat conveyor (which must start
    building in the background, synced to the server's stage_start_time) show
    through faintly while the "Stage N" title was displayed — confusing since
    it looked like the pattern had already started during the dark screen.
    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
2026-07-27 Add Bluetooth bridge firmware; connect ESP32 to PC without WiFi
    New firmware/color_memory_game_bt sends button names over Bluetooth
    Classic SPP (device name "ColorMemoryGame") — no router or IP config
    needed. game_server.py gains a background thread that auto-detects
    /dev/cu.ColorMemoryGame*, reads button names via pyserial, and feeds
    them into the same handle_button() path; it retries every 3s so the
    ESP32 can be power-cycled freely. The HTTP /button route stays for
    browser click-testing and the old WiFi firmware. README now documents
    the Bluetooth setup as the primary flow.
    Claude-Session: https://claude.ai/code/session_01UacSw9UMxB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
2026-07-27 Add Bluetooth heartbeat so a half-dead link self-heals
    After an ESP32 power-cycle, macOS keeps the SPP port "open" with no
    error — readline just returns empty forever — so the server never knew
    to reconnect and buttons stopped arriving after the first session. The
    firmware now sends PING every 2s while connected; the server treats 8s
    of silence as a dead link, closes the port, and reopens it to
    re-establish RFCOMM. Verified with a pty-based reconnect test.
    Firmware and server must be updated together.
    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
    [color_memory_game_bt.ino, game_server.py]
2026-07-27 Clarify BT logs: distinguish "port opened" from "data actually flowing"
    The user's button presses were lost during the 1-2 minute window while
    Bluetooth was still coming up after reflashing, and the old "connected"
    log made that window invisible. Now the server logs when the port opens
    (waiting), when the first bytes actually arrive (link confirmed, remote
    ready), and notes in the failure message that the ESP32 can take a
    couple of minutes to become connectable after boot.
    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
    [game_server.py]
2026-07-27 Make the Bluetooth heartbeat bidirectional to kill ghost connections
    When the server is stopped with Ctrl+C the ESP32 may never receive a
    disconnect event, keeps the old (only) SPP slot occupied, and silently
    rejects every new connection — the server's reopen loop then spins on
    "port opened / 8s silence / retry" forever. Now the server also writes
    PING every 2s (write_timeout=2), and the ESP32 drops any client it
    hasn't heard from in 8s via SerialBT.disconnect(), freeing the slot.
    Either side can now die in any way and the link self-heals in ~20s.
    Verified with a pty test; firmware compiles at 89% flash.
    Claude-Session: https://claude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
2026-07-27 Switch from Bluetooth Classic (SPP) to BLE — SPP is unreliable on macOS
    Even against a freshly rebooted ESP32 (no ghost session possible), macOS
    failed to establish the RFCOMM data path on nearly every cu-port open;
    only 2 connections succeeded all day. Replaced the transport with BLE:
    new firmware color_memory_game_ble (NimBLE, Nordic-UART-style notify
    characteristic, auto re-advertise on disconnect, flash 89%→55%) and a
    bleak-based ble_reader in game_server.py. No pairing needed, no app-level
    heartbeat — BLE supervision timeout handles dead links. Firmware already
    flashed to the board and verified advertising over USB serial.
    Cl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
    [color_memory_game_ble.ino, game_server.py]
2026-07-27 Fix BLE advertising overflow and pin bleak<3; link now verified live
    Two independent bugs kept BLE from connecting: (1) bleak 3.0.2 hangs
    forever in scanning on macOS (raw CoreBluetooth works; downgraded to
    2.1.1, README now says bleak<3 and the server warns if 3.x is loaded),
    and (2) the advertisement packet overflowed 31 bytes with a 128-bit
    service UUID plus the device name, so the ESP32 never appeared in scans
    — the UUID now goes in the advertisement and the name in the scan
    response. The server also matches by service UUID with name fallback.
    Verified end-to-end on hardware: server connects and holds the link.
    Claude-Session: htt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
    [color_memory_game_ble.ino, game_server.py]
2026-07-27 Lift the stage intro curtain before the count-in, not at beat 0
    The opaque intro overlay used to cover the entire 4-beat count-in, so
    when it lifted the first beat was already at the judgment zone and the
    opening notes were effectively invisible. The stage now starts 1.5s
    later (curtain time + count-in), and the client hides the overlay when
    the count-in begins, giving the player four beats of watching the notes
    approach. Verified with timed Playwright screenshots.
    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
2026-07-27 Log power-brownout consultation for battery-powered ESP32
    Claude-Session: https://claude.ai/code/session_016sBDqxH4JdS77pyYxhdWjn
2026-07-27 Add daily top-10 ranking, how-to panel, AI art slots, and slower tempo
    Finished runs are recorded (score, stage, time) to ranking.json keyed by
    date and the day's top 10 shows in a right-side panel with medals and a
    NEW badge; a how-to-play panel sits on the left. Dropping Nano
    Banana-generated images (bg/logo/gameover/allclear png) into
    pc_game/static/img/ now themes the game automatically — prompts for ten
    assets live in PROMPTS.md. Beat interval relaxed 0.55s -> 0.7s.
    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
2026-07-27 Log parts-kit findings: ELEGOO kit has power module + caps for brownout fix
    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
2026-07-27 Log decision: power ESP32 from USB power bank instead of battery box
    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
2026-07-27 Integrate user-generated art: bg, logo, result screens, mascot, hearts, burst
    Processed the Nano Banana images with PIL (auto-crop of dark margins,
    flat-dark-background removal to transparency) and wired them in: page
    background, title logo, game-over / all-clear / stage-clear screens, a
    mascot atop the how-to panel, pixel hearts replacing the emoji lives
    (lost ones dimmed via CSS filter), and a golden burst that flashes on
    EXCELLENT using mix-blend-mode: screen. Art slots now cover 8 names with
    any of png/jpg/jpeg/webp. Source images folder is gitignored; processed
    assets are committed.
    Claude-Session: https://claude.ai/code/session_01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
2026-07-27 Polish the whole UI with a glassmorphism design system
    Design tokens (glass panels, cyan/gold accents, unified radii) drive a
    full visual pass: HUD rebuilt as three frosted chips with tracking-wide
    labels and tabular numbers; the how-to panel now teaches with real
    mini replicas of the ON/OFF/Mode buttons, a note-into-ring diagram, and
    EXCELLENT/OK/MISS badges; the lane gets a glowing judgment zone and
    glossy notes with per-color glow; the remote gains material depth and
    hover states; the stage intro shows READY + gradient lettering; a combo
    counter appears from 2x; the daily #1 ranking row glows gold; the sound
    unlock is a card and the tab has an emoji favicon. Game logic untouched.
    Co-Auth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
2026-07-27 Append a postscript section to the article: Bluetooth-only + visual overhaul
    The original article stays untouched; a dated postscript (#postscript)
    reports that talking with the AI revealed the WiFi router was never
    needed — BLE alone connects the ESP32 to the PC, shrinking the rig to
    light + ESP32 + power bank — and that AI-generated art plus a design
    pass made the game look the part. Adds a compressed 720p demo video of
    the Bluetooth build with poster, the minimal-setup photo (EXIF rotation
    fixed), and a screenshot of the new game screen.
    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
2026-07-27 Fix squished postscript video and add a floating jump-nav menu
    The source clip carries a -90 rotation flag (actually portrait) but the
    prior encode forced scale=1280:720, squishing the content landscape.
    Re-encoded at 720:1280 to match the article's other video, matching its
    actual orientation.
    Also added a fixed round menu button (bottom-right, CSS-only
    details/summary, no JS required to open/close) listing all 10 sections
    with their color chips so readers can jump directly instead of
    scrolling the whole article. A few lines of JS close the menu after a
    link is clicked.
    Claude-Session: https://claude.ai/code/session_01UacSw9UMxB1qPVAf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
2026-07-28 オープンキャンパス向けページを新規リポジトリ(opencampus-sensor-lab)として分離
    本体プロジェクトのフォルダ内にサブフォルダを作り、独立したgitリポジトリとして
    別のGitHub公開リポジトリに切り出した。ネスト管理を避けるため .gitignore に追加。
    Claude-Session: https://claude.ai/code/session_011HQp4CiCf2eBV7G1YSjQZS
2026-07-30 ガチャガチャロック連携をBLEで実装(友人のgacha-machineプロジェクトと連携)
    スコア500点以上でゲーム終了すると、firmware/gacha_lock_ble を書き込んだ
    ガチャ機側ESP32にBLEで解錠コマンドを送る。WiFi不要でColorMemoryGameの
    BLE接続とも共存する。実機テストではガチャ機ESP32個体の無線ハードウェア
    故障(BLE/WiFi共に電波が出ない)が判明したためE2E動作確認は未完了。
    Claude-Session: https://claude.ai/code/session_01878b5jAzZRZNZFWsvfrgX1
2026-07-30 GachaLockのBLE Service UUIDをColorMemoryGameと分離(誤接続バグの修正)
    実機テストで、両ファームが同じNordic UART Service UUIDを使っていたため、
    サービスUUID一致だけで判定するgacha_ble_readerがColorMemoryGame側のESP32に
    誤接続し、ボタン通知をガチャの状態として受信してしまう事故を確認。
    GachaLock側を専用の別UUIDに変更して解消。
    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
    [gacha_lock_ble.ino, game_server.py]
2026-07-30 SESSION_LOG: UUID衝突バグの発見・修正の経緯を追記
    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
2026-07-30 ガチャBLE解錠が動かない2つのバグを修正(実機で解錠成功を確認)
    1. 広告パケットの構成: デバイス名をスキャン応答に入れていたため、電波が弱いと
    名前取得の往復通信が成立せずデバイスとして全く発見できなかった。名前を広告本体に
    直接入れ、サービスUUIDをスキャン応答に回す構成へ変更。送信出力も明示的に最大化。
    2. 書き込み方式の不一致: ファーム側はWRITE(応答あり)なのにPC側がresponse=False
    (Write Without Response)で送っており、コマンドが破棄されて解錠されなかった。
    response=Trueに修正(到達確認が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
    [gacha_lock_ble.ino, game_server.py]
2026-07-30 ガチャ機ディスプレイのAI画像表示に対応(3状態 + ありがとう画面を新設)
    - PROMPTS.md: ロック中/解錠中/ありがとうの3枚分のAI生成プロンプト(既存マスコットと
    アートスタイルを踏襲、320x170横長向けのレイアウト指示付き)
    - make_images.py: 画像をRGB565のC配列(images.h)へ変換。中央基準のcoverトリミング
    - ファーム: images.h があれば全画面イラスト、無ければ従来の図形描画にフォールバック。
    ST_THANKS状態を追加し、カプセル検知時は先に施錠してからお礼を3秒表示する
    - images.h(自動生成・約1.1MB)は.gitignoreへ
    仮画像でパイ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
2026-07-30 ガチャ機ディスプレイの表示画像3枚を追加(実機で表示・遷移を確認済み)
    ユーザーがAI生成した「ロック中 / かいじょ! / ありがとう!」の3枚。
    日本語も崩れずキャラクターの統一感もあるため、そのまま採用。
    1424x752(比率1.89:1)で、目標の320x170(1.88:1)とほぼ一致するため
    トリミングはほぼ発生しない。
    実機検証: 解錠指示 → 「かいじょ!」表示 → 赤外線センサーがカプセル検知 →
    先に施錠して「ありがとう!」を3秒表示 → 「ロック中」へ復帰、まで確認。
    images.h は自動生成物のためgitignore。この元画像から make_imag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
2026-07-30 ロック中の画像を差し替え(文言を「高得点を目指そう!」に変更)
    「500てんとってね」から「高得点を目指そう!」へ。キャラも困り顔に変更。
    実機に書き込み・表示確認済み。
    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
2026-07-30 練習モードをエンドレス化 + 目標点数を挑戦者が選べるように
    練習モード:
    - 「押したら光るだけ」から、3拍ごとにノーツが流れ続けるエンドレスモードに変更。
    ステージ制の16拍固定パターンとは別に「絶対ビート番号」で管理し、必要な分だけ
    遅延生成して古いノーツは破棄する(サーバー・クライアント双方)。
    - 判定と音は出るがライフは減らず、ゲームオーバーにもならない。OFFで終了。
    - クライアントはコンベアを作り直すのではなく、未出のノーツを足して流れ切ったものを
    DOMから消す方式にした(エ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
2026-07-30 練習モードに空白ビートを追加 + 目標選択画面の操作性を改善
    練習モードの修正(実装漏れ):
    - 色ノーツの間の「空ビートの輪」が流れていなかったため、拍が取れず非常に叩きにくく、
    さらに輪が判定ゾーンを通るときのメトロノーム音も鳴っていなかった。
    サーバーが描画すべきビート範囲(window)を返すようにし、色の無いビートも輪として
    流すよう修正。本編と同じリズムの手がかりと音が出るようになった。
    目標選択画面:
    - 縦積みだとリモコンが画面外に切れていたため、サイドパネル・レーン・ロゴを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
    [game_server.py]
2026-07-30 結果画面を新設し、ガチャのロック状態を追いかけて次の人へ繋ぐループを実装
    これまで結果が1行のメッセージだけで「失敗して終わり」に見えていたため、
    結果パネルを新設してフィードバックを明確にした。
    - スコアと目標を並べて表示し、達成なら「≥」、未達なら「<」+「あと○点でした」を出す
    - 達成時はガチャの進行を4段階(ロック解除→ガチャを回す→カプセル排出→再ロック)で
    段階表示し、今どこにいるかが分かるようにした
    ガチャ機の実状態を追跡:
    - ファームが送る "LOCKED"/"UNLOCKED"/"DISPENSED" 通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
2026-07-30 管理者パネルを追加(右下常駐・手動で信号を送れる逃げ道)
    イベント中に「ガチャが詰まった」「解錠信号が届かなかった」等が起きたときに
    運営が手動で介入できるようにした。合言葉は付けない(手元運用のため)。
    ファームウェア:
    - UNLOCK しか受け付けていなかったので LOCK(強制施錠)と STATUS(状態問い合わせ)を追加。
    どちらも状態に関係なくloop先頭で処理する。stateName() で状態文字列を一元化
    サーバー:
    - ガチャへのBLE書き込みを send_gacha_command() に切り出して再利用可能にした
    - POST /admin/action を追加。gacha_unloc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
2026-07-30 SESSION_LOG: ディスプレイ画像化・ゲーム性改良・管理者パネルの記録を追記
    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
2026-07-30 管理パネルにBLEの接続品質(接続時間・再接続回数)を追加
    置き場所が悪いと電波が届かない問題を運営が自分で判断できるように、
    ガチャ機BLEの「接続してからの経過時間」と「再接続回数」を表示する。
    再接続が0回なら緑、増えるほど警告色になる。
    ※調査で判明したこと: 以前「同機種比較で20dB弱い=アンテナ劣化」と結論したのは誤り。
    実際は①2台は別チップ(ガチャ機=ESP32-D0WD rev1.1 / リモコン側=D0WD-V3 rev3.1)で
    同機種比較が成立していなかった ②置き場所を変えたら -66dBm まで改善し、
    リモコン側(-76dBm)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
2026-07-30 SESSION_LOG: 「ガチャ機のアンテナ劣化」という誤った結論を訂正
    再調査で、2台が別チップ・別機種で同機種比較が成立していなかったこと、
    置き場所を変えたら -66dBm(リモコン側より強い)まで改善したことが判明。
    ボードは正常で原因は設置位置だった。
    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
2026-07-30 SESSION_LOG: 実機での通しプレイ成功を記録(全経路の動作確認完了)
    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
2026-07-30 BLE切断で排出通知を取りこぼすと復帰できない問題を修正
    実イベント中に「ガチャは排出されたのに、PC側が排出を確認できず次に進めない」
    という症状が発生。調査すると、ガチャ機側は正常に検知・再施錠まで完了しており、
    原因は排出待ちの最中にBLEが切断され(再接続3回)、"DISPENSED"/"LOCKED" の通知が
    PCに届かなかったことだった。
    修正:
    - 接続直後に必ず STATUS を送って現在の状態を同期するようにした。
    ファーム側も onConnect で状態を通知しているが、それはPC側が start_notify を
    終える前に飛ぶことがあり取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
    [game_server.py]
2026-07-31 排出検知から施錠までに遅延(200ms)を入れて、回転盤が良い位置で止まるようにした
    実機で調整したところ、カプセルが落ちた瞬間に施錠すると回転盤のポケットが
    まだ開いた位置で止まってしまい、機構が中途半端なところで引っかかっていた。
    少し待って回転盤が進んでから爪を落とすことで、きれいに止まる。
    - LOCK_DELAY_MS(既定200ms)を上部の調整用定数として追加
    - thanksThenLock() は施錠せず状態遷移だけ行い、実際の施錠は loop の
    ST_THANKS 処理で LOCK_DELAY_MS 経過後に行う(ノンブロッキング)
    - 検知直後にあった del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
2026-07-31 結果発表に演出を追加(さらっと終わっていたので溜めを作った)
    結果が出た瞬間に全部表示され、すぐ解錠されるだけであっけなかったので、
    時間をかけて盛り上げる流れにした。
    タイムライン(実測):
    0〜1.8秒 スコアを0からカウントアップ(音を刻む)
    2.3〜2.7秒 「判定中...」で溜める(点が順に光る)
    3.2秒 判定を出して「目標たっせい!」を大きく発表
    金色グラデ+パネル発光+バースト+ファンファーレ+スタンプ表示
    4.2秒 ★ここでサーボが解錠される
    4.5秒 ガチャの進行段階表示に引き継ぐ
    - サ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
2026-07-31 ガチャ機の通信をBLEからWiFi(HTTP)に移行
    BLEは電波が弱いと接続が頻繁に切れ、実イベントで「排出したのに次の人に進めない」
    問題が起きたため、ローカルLAN経由のHTTPに乗り換えた。
    リモコン側(ColorMemoryGame)は安定しているのでBLEのまま。
    ファームウェア firmware/gacha_lock_wifi を新規追加:
    - WiFi STAで接続し、HTTPサーバーとして待ち受ける
    GET /status(状態) / /unlock(解錠) / /lock(強制施錠) / ブラウザ確認用の /
    - mDNSで gacha.local を名乗るのでIPが変わっても設定変更不要
    - 排出のたびに増える通算カウンタを返す。通信が一瞬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
2026-07-31 SESSION_LOG: オープンキャンパス用A4ポスターの生成プロンプト作成を記録
    Claude-Session: https://claude.ai/code/session_01YVoJp2ARZbzoQe68m4oXsn
2026-07-31 ゲームUIの操作感を改善(音の追加・ステージ自動進行・結果後の戻り先)
    ユーザーからの指摘4点に対応。
    1. ONを押しても音が鳴らなかった
    目標選択に入る流れを追加した際、ONに手応えが無くなっていた。
    2音重ねの確定音(523→784Hz)を鳴らすようにした。
    目標を選んで開始したときの音(659→880→1046Hz)も追加。
    2. 難易度選択のハイライトに音が無かった
    1秒ごとの巡回に合わせて、かんたん→神 の順に音程が上がるようにした
    (ドレミファソの全音階 523/587/659/784/880Hz)。どのボタンが今光っているか
    目を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
2026-07-31 「早すぎ」で押した後に待たされる問題を修正(全ノーツ判定でステージ即終了)
    ノーツが実際に流れてくる前に押して「早すぎ」判定になった場合、そのノーツは
    判定済みなのに、ステージ終了はクロック(最後のビート+1拍)を待つ作りだったため、
    何もすることがないまま数秒待たされていた。
    - 全ノーツの判定が終わった時点(next_active_index が None)で、猶予0.45秒だけ
    最後の判定表示を見せてからステージを終える(STAGE_END_GRACE_SEC)
    - 従来の時間ベースの終了条件は、まだ未判定のノーツが残っている場合の保険とし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
    [game_server.py]
2026-07-31 カウントダウンが見えない問題を修正(画面下の文字→中央のオーバーレイへ)
    「3,2,1が出ない、画面がカクっとするだけ」という指摘を調査。コード自体は動いて
    いたが、表示位置が悪くて気づけない状態だった:
    - カウントダウンを画面下のメッセージ欄に出していたが、この欄はリモコンの下に
    あるため、ウィンドウが低いと画面外に出る(1280x700で見切れることを実測)
    - 見えている場合も画面最下部の小さな文字なので、ノーツを見ている視線からは
    気づけない
    そこで専用のオーバーレイ(#clearOverlay)を新設し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
2026-07-31 SESSION_LOG: 解説ページのデモ動画枠追加とWiFi化の記述変更を記録
    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
2026-07-31 SESSION_LOG: opencampus リポジトリへの push 済みを反映
    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
2026-07-31 カウントダウンを1本に統一(3,2,1の後にさらに数え直す問題を解消)
    「321で流れた後にステージに入ると3214みたいになる」という指摘。
    ステージクリア側で3・2・1を出し、その後さらに4拍のカウントインが入るため、
    二重に数えているように見えていた。
    - カウントダウンはカウントインに一本化。COUNT_IN_BEATS を 4→3 にし、
    その拍に合わせて 3→2→1 を出してそのままノーツに入るようにした
    (数字は実際の拍と同期するので、リズムを取る役目も兼ねる)
    - ステージクリア表示からは数字を外し、「STAGE N CLEAR!」と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
2026-07-31 カウントダウンが「3,2,1,1」になるバグを修正 + 次ステージの予告を削除
    1. 最後の「1」が二度出る問題
    数字のアニメーションに animation-fill-mode の指定が無かったため、
    アニメーション終了後に元の表示状態(不透明)へ戻ってしまい、
    消えたはずの数字がもう一度現れていた。forwards を指定し、
    .show の初期状態も opacity:0 にして解消。
    実測で 3(4.09s) → 2(4.79s) → 1(5.43s) の一回ずつになったことを確認。
    2. 次ステージの予告(「つぎは ノーツが○個 流れてくるよ」)を削除
    要望により撤去。クリア表示は「STA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
    [game_server.py]
2026-07-31 SESSION_LOG: 撮影リストの作成を追記
    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
2026-08-01 展示用に全画面表示の手段を追加(ブラウザのバーを消す)
    - 管理パネル(右下の🛠)に「全画面にする」ボタンを追加。押すたびに切り替わり、
    ラベルも状態に応じて変わる。全画面にできない環境では ⌃⌘F を案内する
    - 管理ボタンのイベント登録を .ad-btn[data-action] に絞り、全画面ボタンが
    サーバーAPIを叩かないようにした(他の管理操作が壊れていないことも確認済み)
    - 動作用.txt を起動手順のメモとして整備:
    Chromeのキオスクモード(バーもタブも出ない)での起動コマンド、
    通知を切る方法、画面を暗くしない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
2026-08-01 SESSION_LOG: 撮影素材の反映を記録
    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
2026-08-01 WiFi再接続時に "sta is connecting, return error" を量産する問題を修正
    接続を試している最中(WL_IDLE_STATUS)にも5秒ごとに WiFi.reconnect() を
    呼んでいたため、エラーログが延々と出ていた。切断が確定した状態
    (WL_CONNECTION_LOST / WL_DISCONNECTED / WL_CONNECT_FAILED)のときだけ
    呼び直すようにした。接続/切断のログも状態が変わったときだけ出す。
    初回接続の処理には触れていない(実機で IP取得・RSSI -56dBm を確認済み)。
    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
    [gacha_lock_wifi.ino]
2026-08-01 ガチャ機の通信をUSBシリアル直結に変更(無線をやめて電波問題を根絶)
    BLE→WiFiと移してきたが、どちらも会場の電波・ネットワーク事情に左右され、
    実イベントで「排出したのに次に進めない」「gacha.localに繋がらない」等の
    トラブルが続いた。USBケーブル1本で直結する方式に切り替え、電波の問題を
    原理的に無くした。(リモコン側 ColorMemoryGame は手持ちで使うためBLEのまま)
    ファームウェア firmware/gacha_lock_serial を新規追加:
    - シリアル(115200bps)で行をやり取りする
    PC → ESP32 : UNLOCK / LOCK / STATUS
    ESP32 → PC : #GACHA st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
2026-08-03 まず読むメモ(START_HERE.md)を追加
    久しぶりに開いたときに、README(手順書)とSESSION_LOG(作業記録)の
    どちらを読めばいいか分からなくなるので、5分で全体を掴むための1枚を用意した。
    - 一行要約 / 現在の構成(mermaid図と、区間ごとの通信方式の表)
    - 動かし方3ステップ / フォルダの歩き方
    - これまでの物語を7章立てで記事化(100均で部品を漁る → 無線との長い戦い →
    見た目 → ガチャ連携 → 展示に耐える形へ → 本番と有線回帰 → 外向けページ)。
    途中で2回やらかした誤診(無線ハード故障・アンテナ劣化)もそのまま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
2026-08-03 散らかっていたルート直下の写真・動画を 素材/ に集約して名前を付け直した
    ルートに IMG_6308.jpeg のような何が写っているか分からない写真が13枚と、
    4Kの元動画2本(436MB)、ポスターのPDFが直置きされていて、
    フォルダを開いても何のプロジェクトなのか分からない状態だった。
    どの写真が何なのかは、元画像と site/images 等の加工済み画像の相関を
    PILで取って機械的に同定した(13枚中12枚が相関1.00で一意に確定)。
    素材/
    ├── 写真_製作/ 01〜12(LEDライトの基板、配線、はんだ付け…)
    ├── 写真_オープン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
